aescariom/In3/circuits/In3Bluetooth_HC-05/bluetooth_board.png

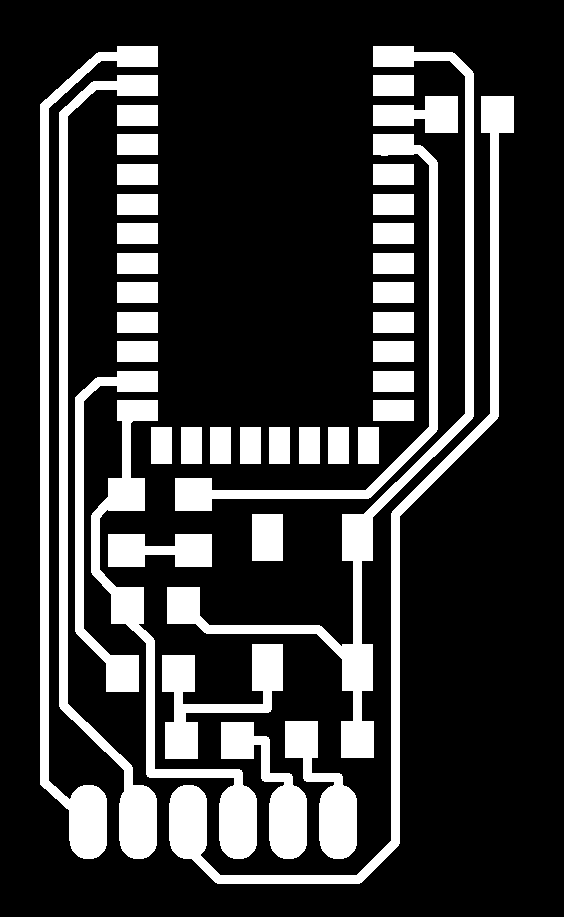
circuits/In3Bluetooth_HC-05/bluetooth_board.png
