aescariom/In3/circuits/In3Bluetooth_HC-05/bluetooth_cut.png

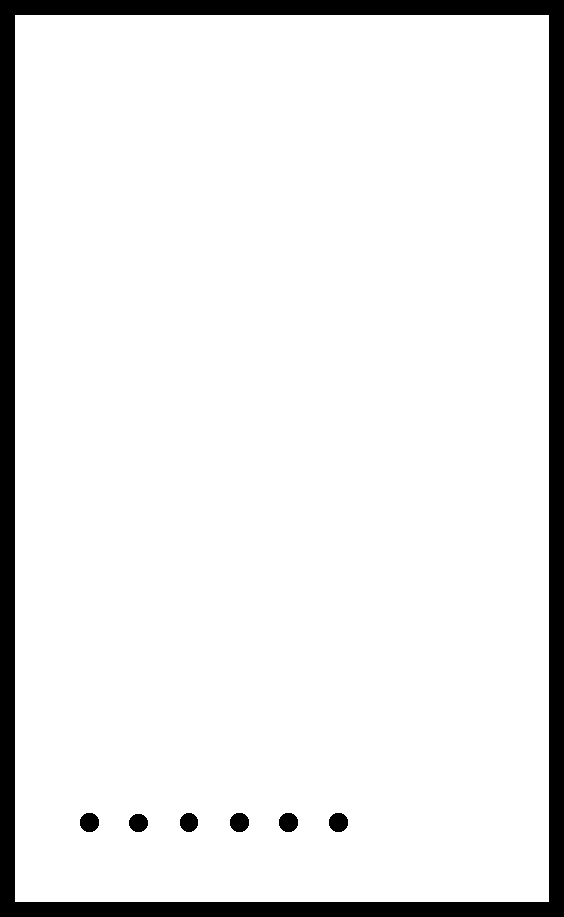
circuits/In3Bluetooth_HC-05/bluetooth_cut.png
