aescariom/In3/structure/3D printing/left_nozzle.stl

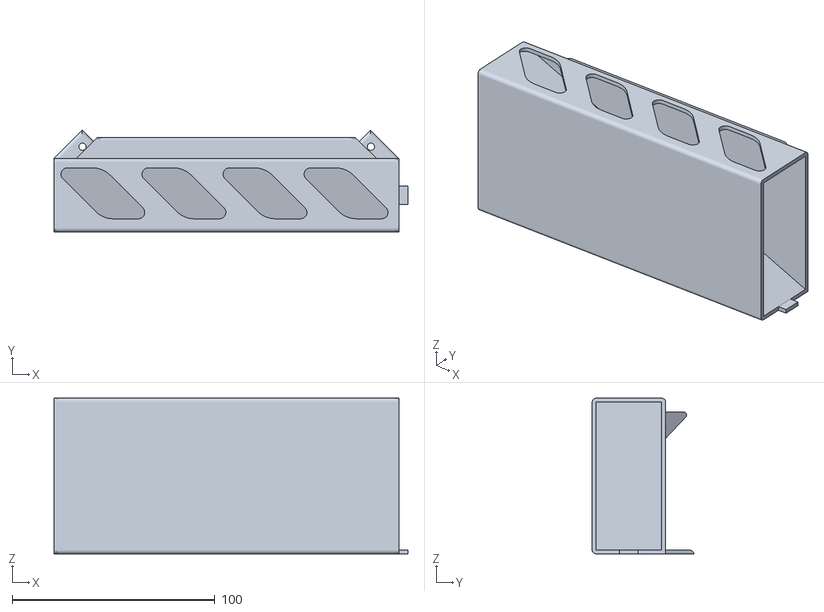
[picture p3: CAD file, 2015-09-20]
structure/3D printing/left_nozzle.stl
174.6 x 50.2 x 76.8
