aescariom/In3/structure/Cut/in3_base_30mm.dxf

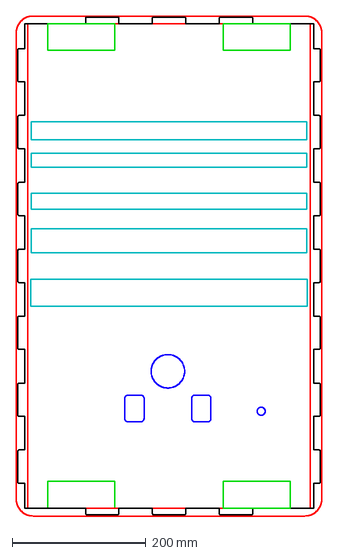
[picture p4: CAD file, 2015-09-20]
structure/Cut/in3_base_30mm.dxf
456.4 x 747.4 mm
