aescariom/In3/structure/Molding & Casting/axis/negative_mold.stl

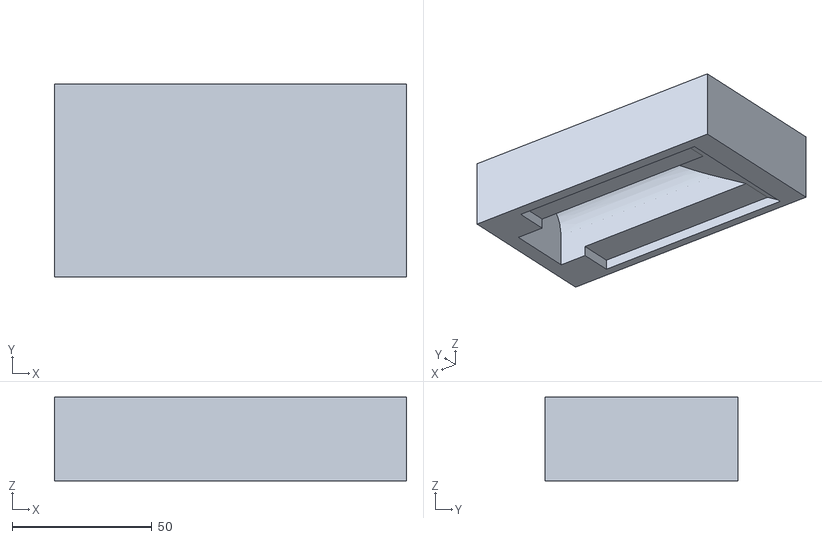
[picture p5: CAD file, 2015-09-20]
structure/Molding & Casting/axis/negative_mold.stl
126.0 x 69.0 x 30.0
