aescariom/In3/structure/3D printing/nozzle_splitter.stl

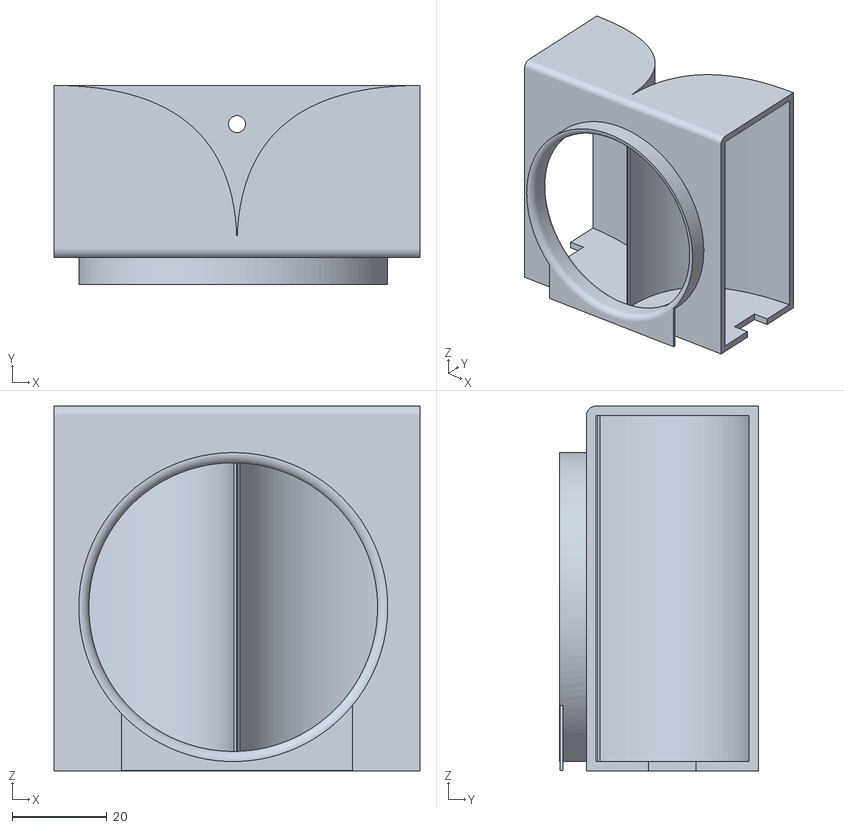
[picture p6: CAD file, 2015-09-20]
structure/3D printing/nozzle_splitter.stl
77.1 x 41.9 x 76.8
