aescariom/In3/structure/Cut/in3_legs_17.5mm.dxf

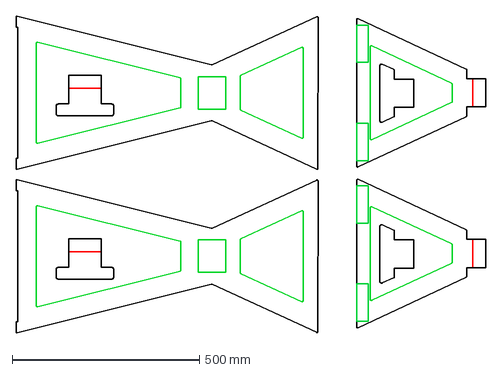
[picture p7: CAD file, 2015-09-20]
structure/Cut/in3_legs_17.5mm.dxf
1254.4 x 844.8 mm
