aescariom/In3/structure/Cut/in3_box_10mm.dxf

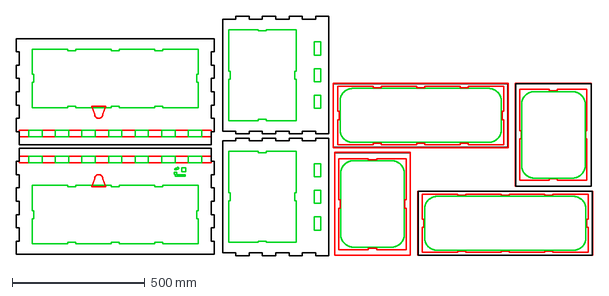
[picture p8: CAD file, 2015-09-20]
structure/Cut/in3_box_10mm.dxf
2168.4 x 899.7 mm
