aescariom/In3/structure/3D printing/tube.stl

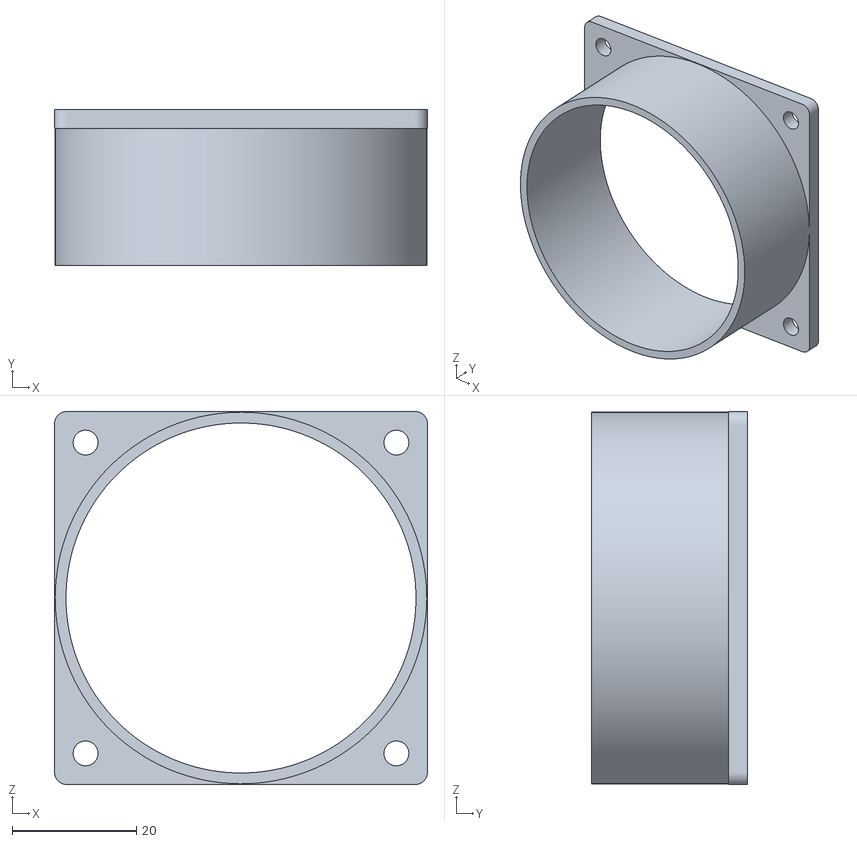
[picture p9: CAD file, 2015-09-20]
structure/3D printing/tube.stl
60.0 x 25.0 x 60.0
