aescariom/In3/structure/Cut/in3_bed_15mm.dxf

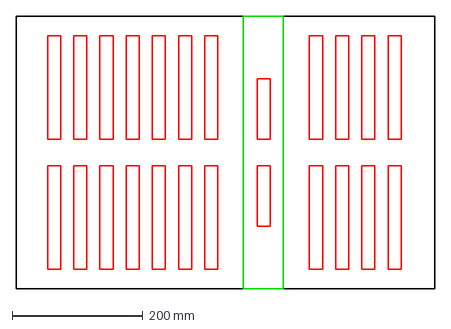
[picture p10: CAD file, 2015-09-20]
structure/Cut/in3_bed_15mm.dxf
638.6 x 416.0 mm
