aescariom/In3/structure/3D printing/corner.stl

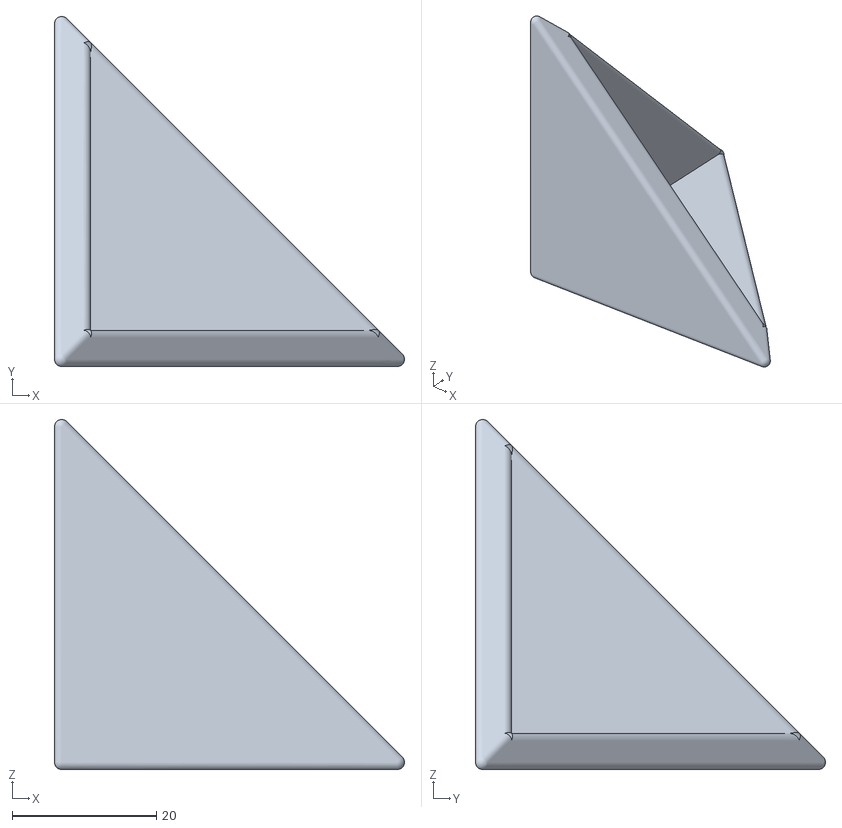
[picture p11: CAD file, 2015-07-16]
structure/3D printing/corner.stl
48.6 x 48.6 x 48.6
