aescariom/In3/structure/3D printing/inner_ring.stl

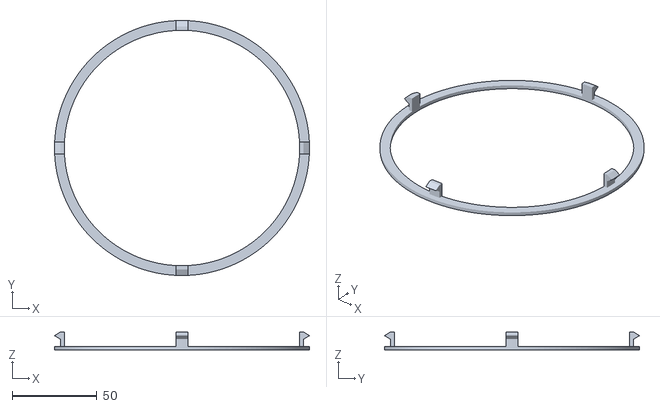
[picture p12: CAD file, 2015-07-16]
structure/3D printing/inner_ring.stl
150.8 x 150.8 x 10.6
