aescariom/In3/structure/3D printing/outter_ring.stl

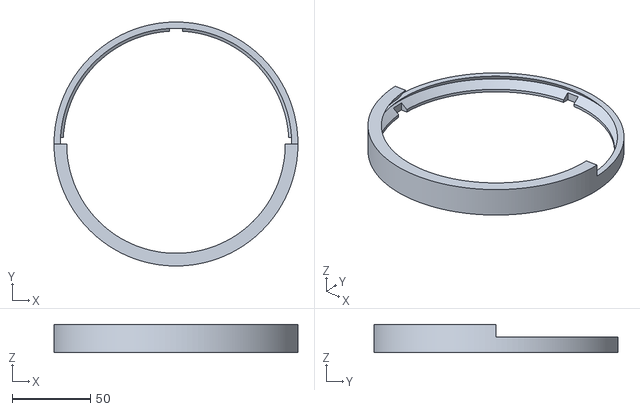
[picture p13: CAD file, 2015-07-16]
structure/3D printing/outter_ring.stl
155.5 x 155.5 x 17.9
