aescariom/In3/(list of files, cad)

Other CAD files:
structure/3D printing/right_nozzle.stl
