aescariom/In3/docs/structure_assembling/Assembling.tex

\documentclass{article}
\usepackage[a4paper,margin=1in,landscape]{geometry}
\usepackage{blindtext}
\usepackage{tikz}
\usetikzlibrary{calc}
\begin{document}
\begin{center}
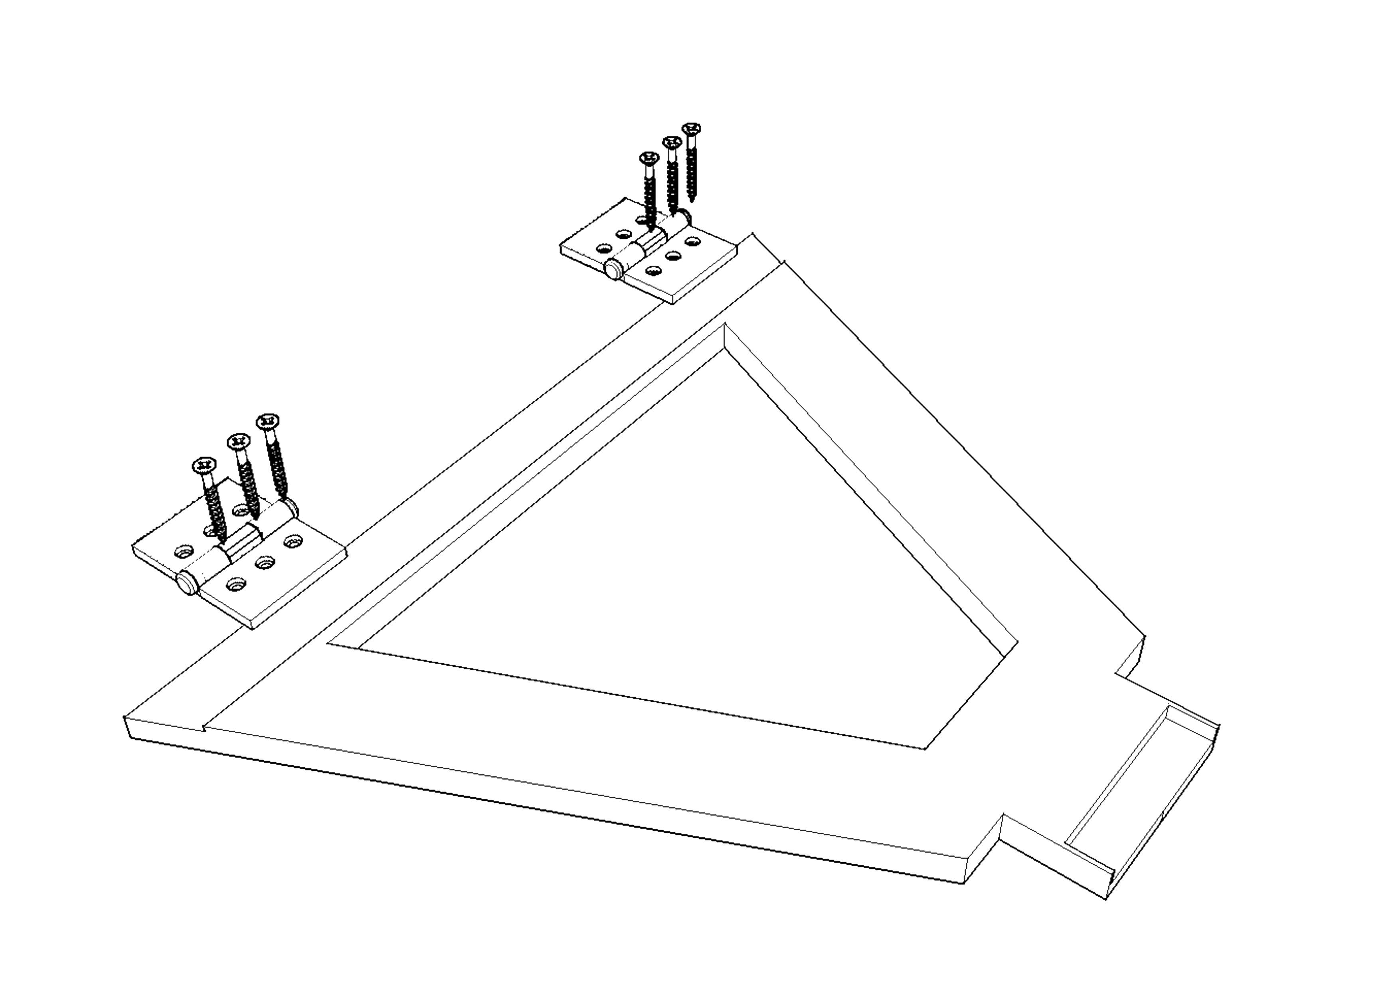
[picture p14: docs/structure_assembling/assembling/step1.png]
	
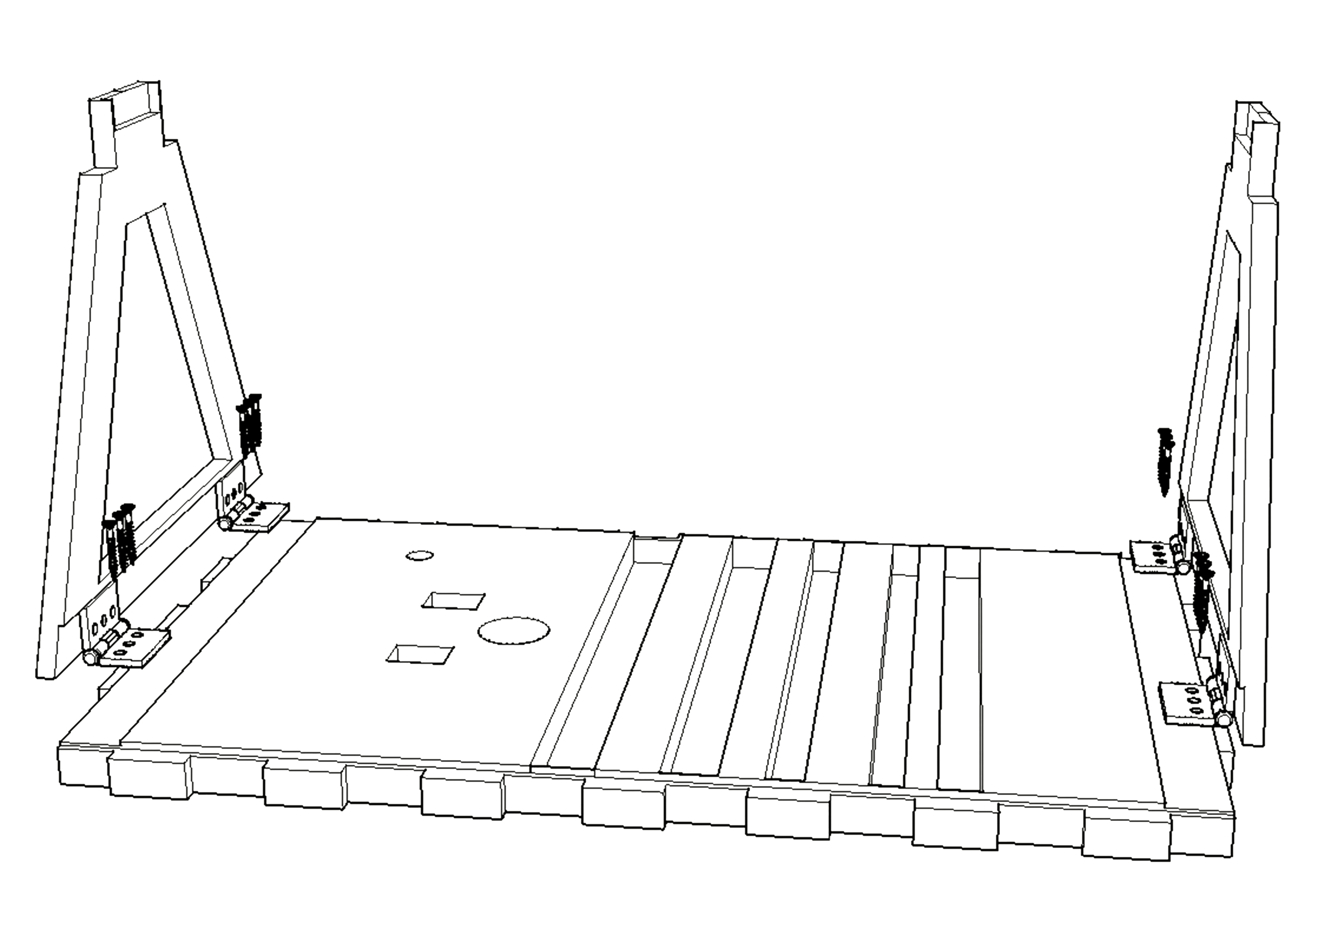
[picture p15: docs/structure_assembling/assembling/step2.png]
	
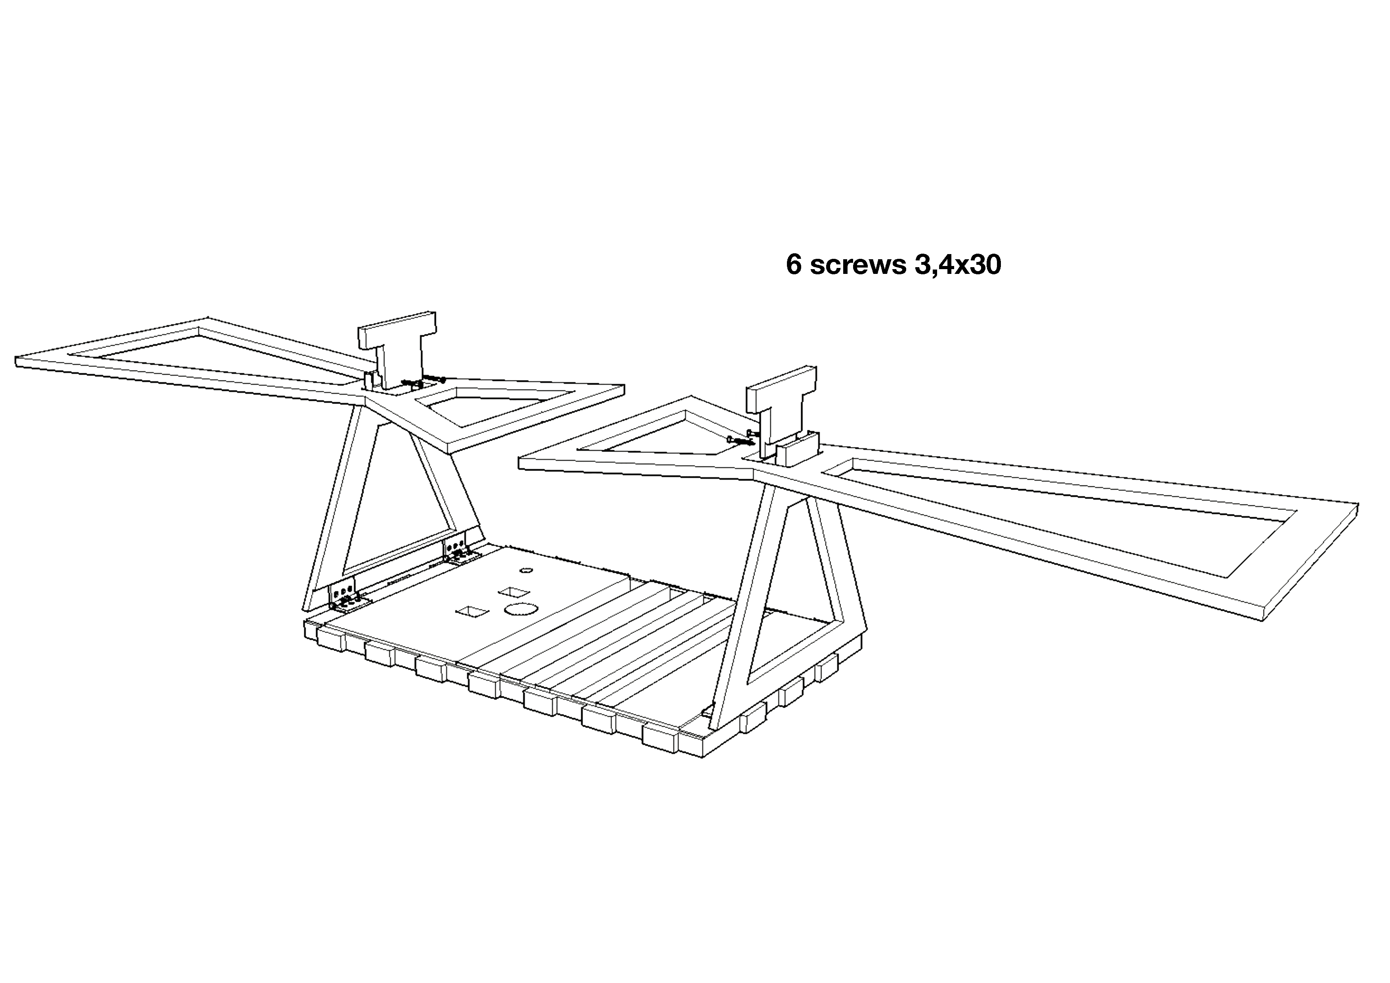
[picture p16: docs/structure_assembling/assembling/step3.png]
	
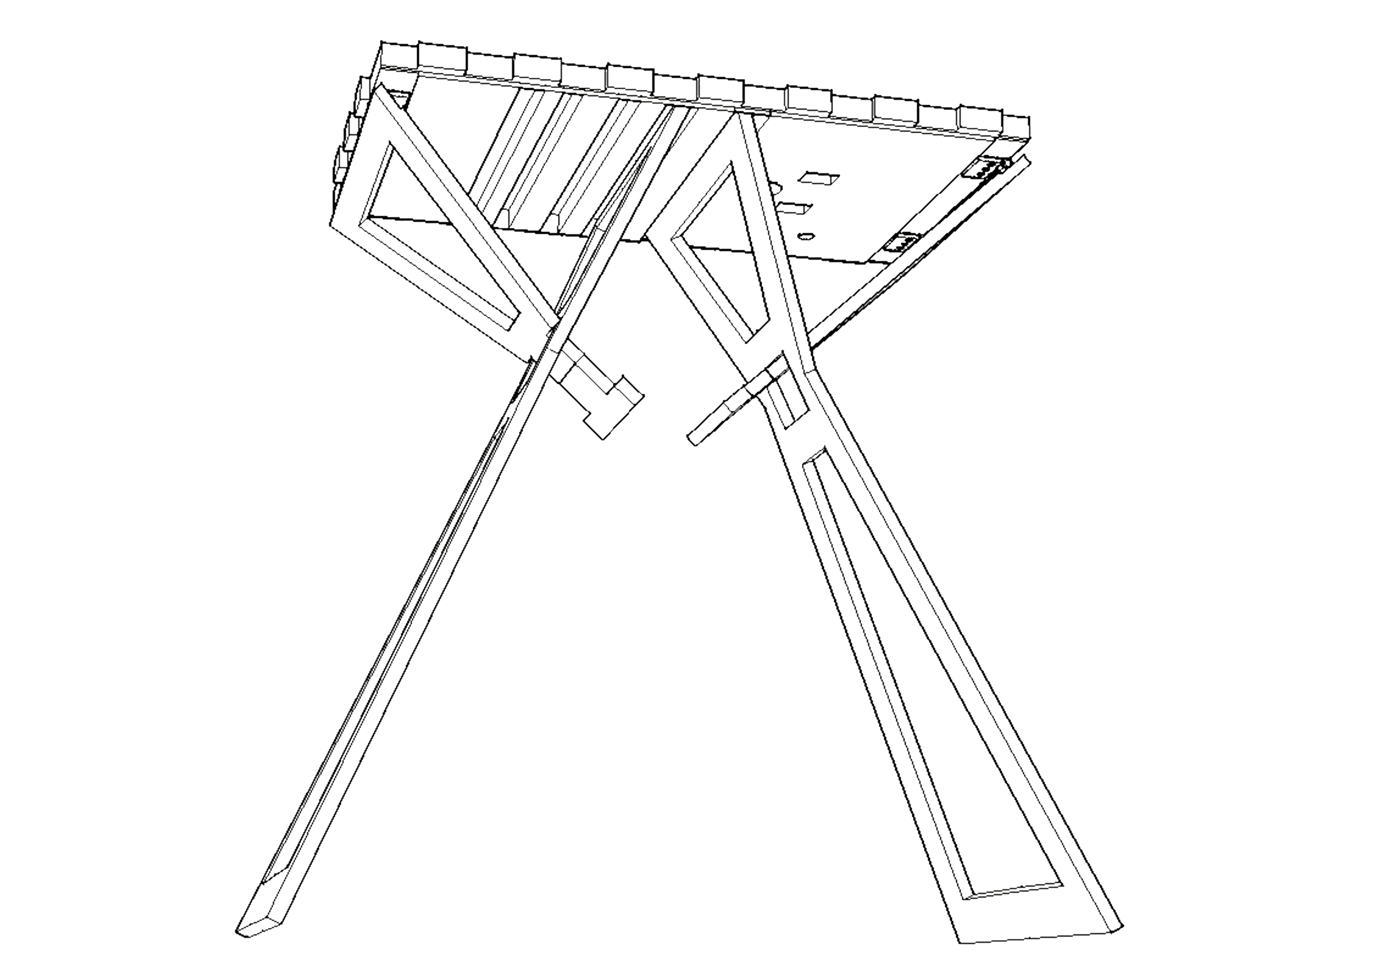
[picture p17: docs/structure_assembling/assembling/step4.png]
	
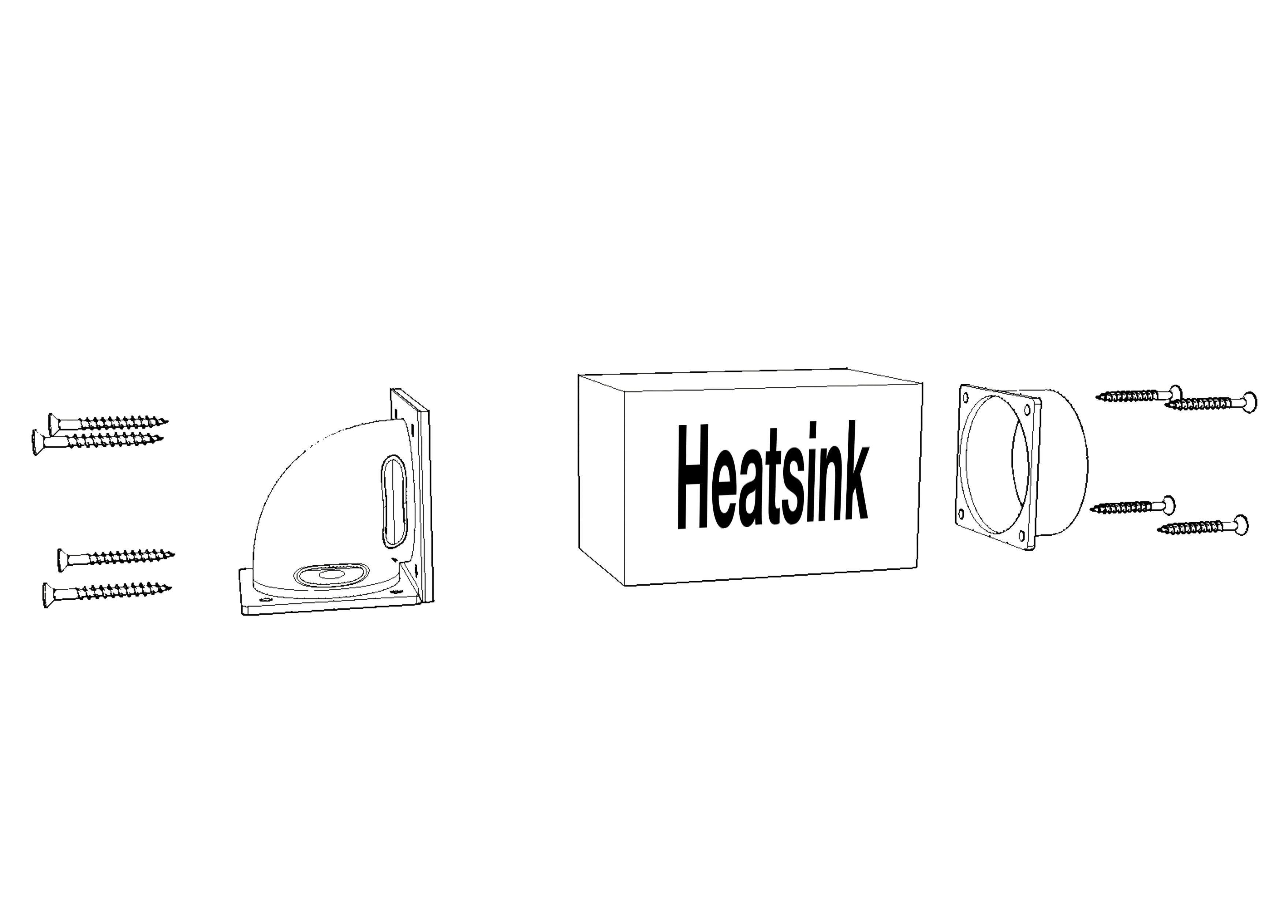
[picture p18: docs/structure_assembling/assembling/step5.png]
	
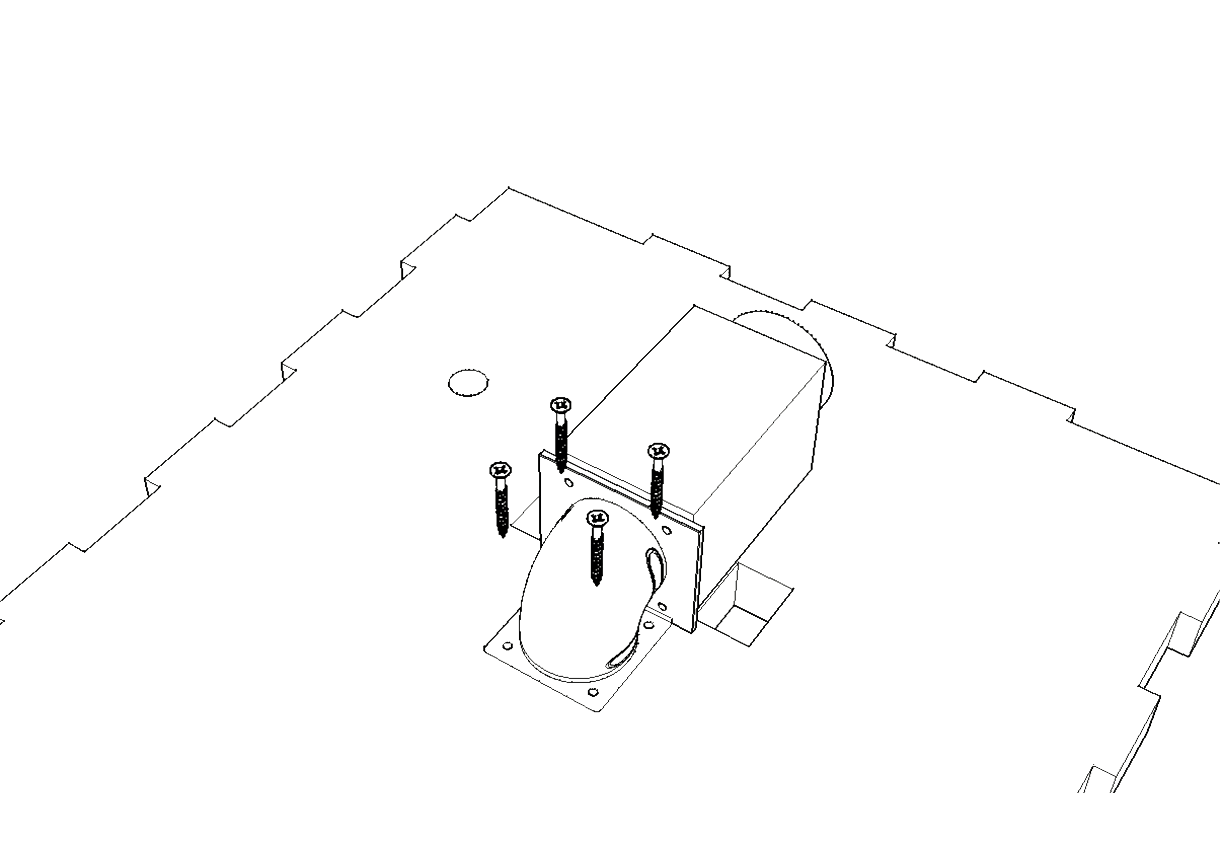
[picture p19: docs/structure_assembling/assembling/step6.png]
	
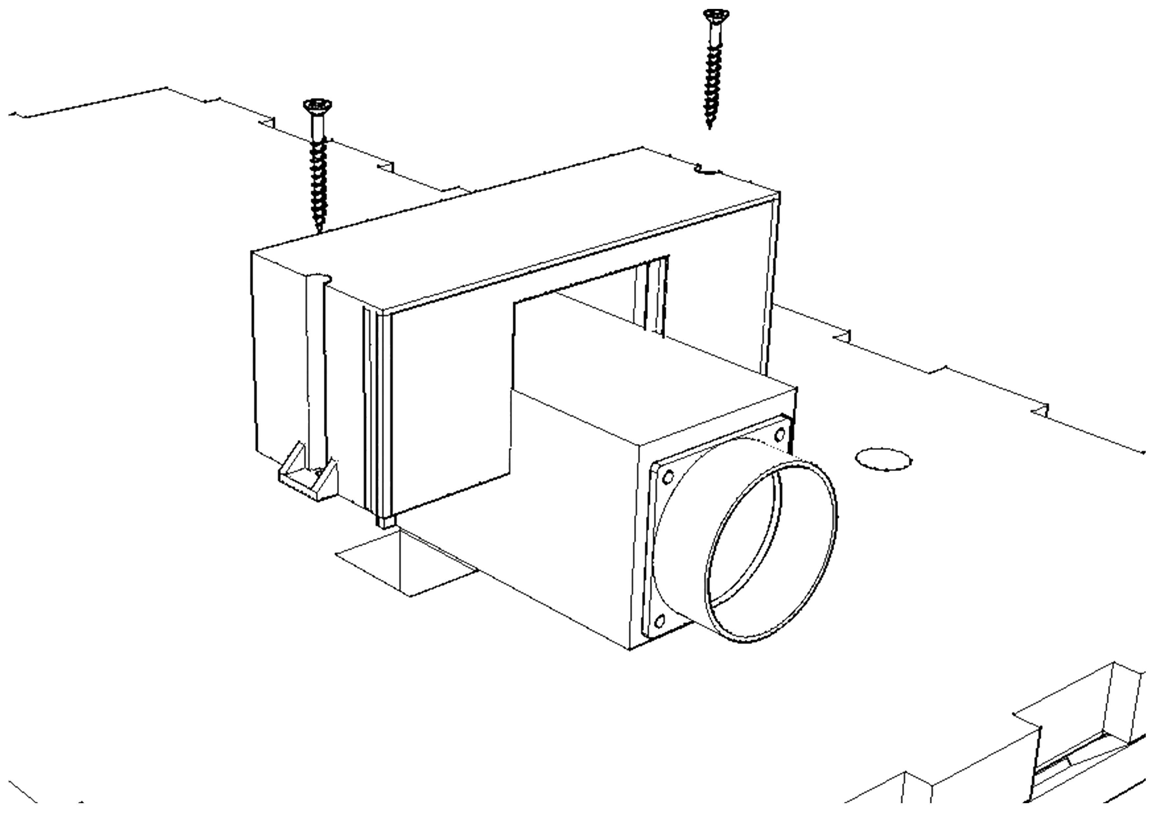
[picture p20: docs/structure_assembling/assembling/step7.png]
	
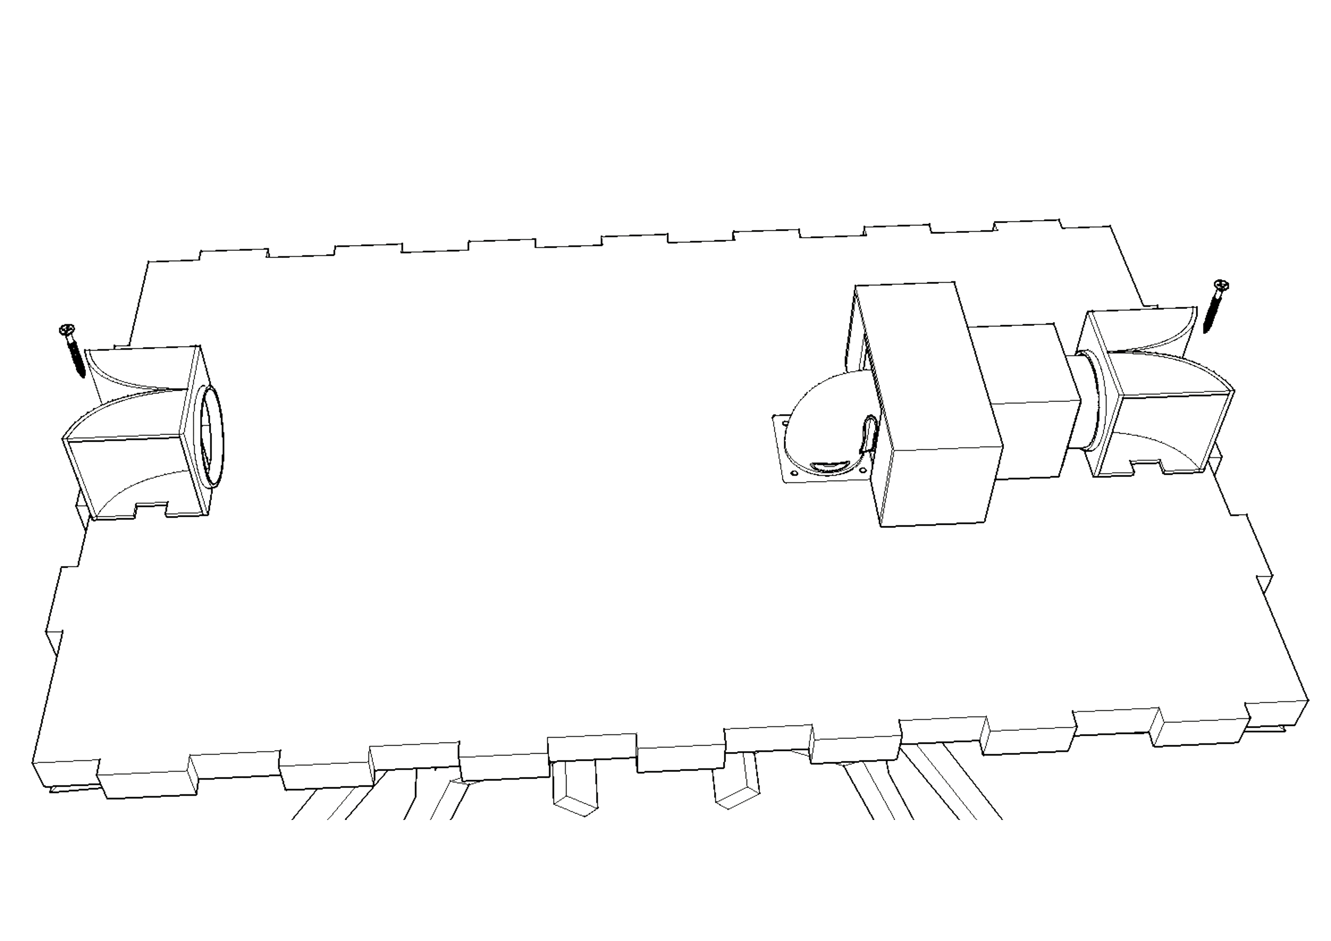
[picture p21: docs/structure_assembling/assembling/step8.png]
	
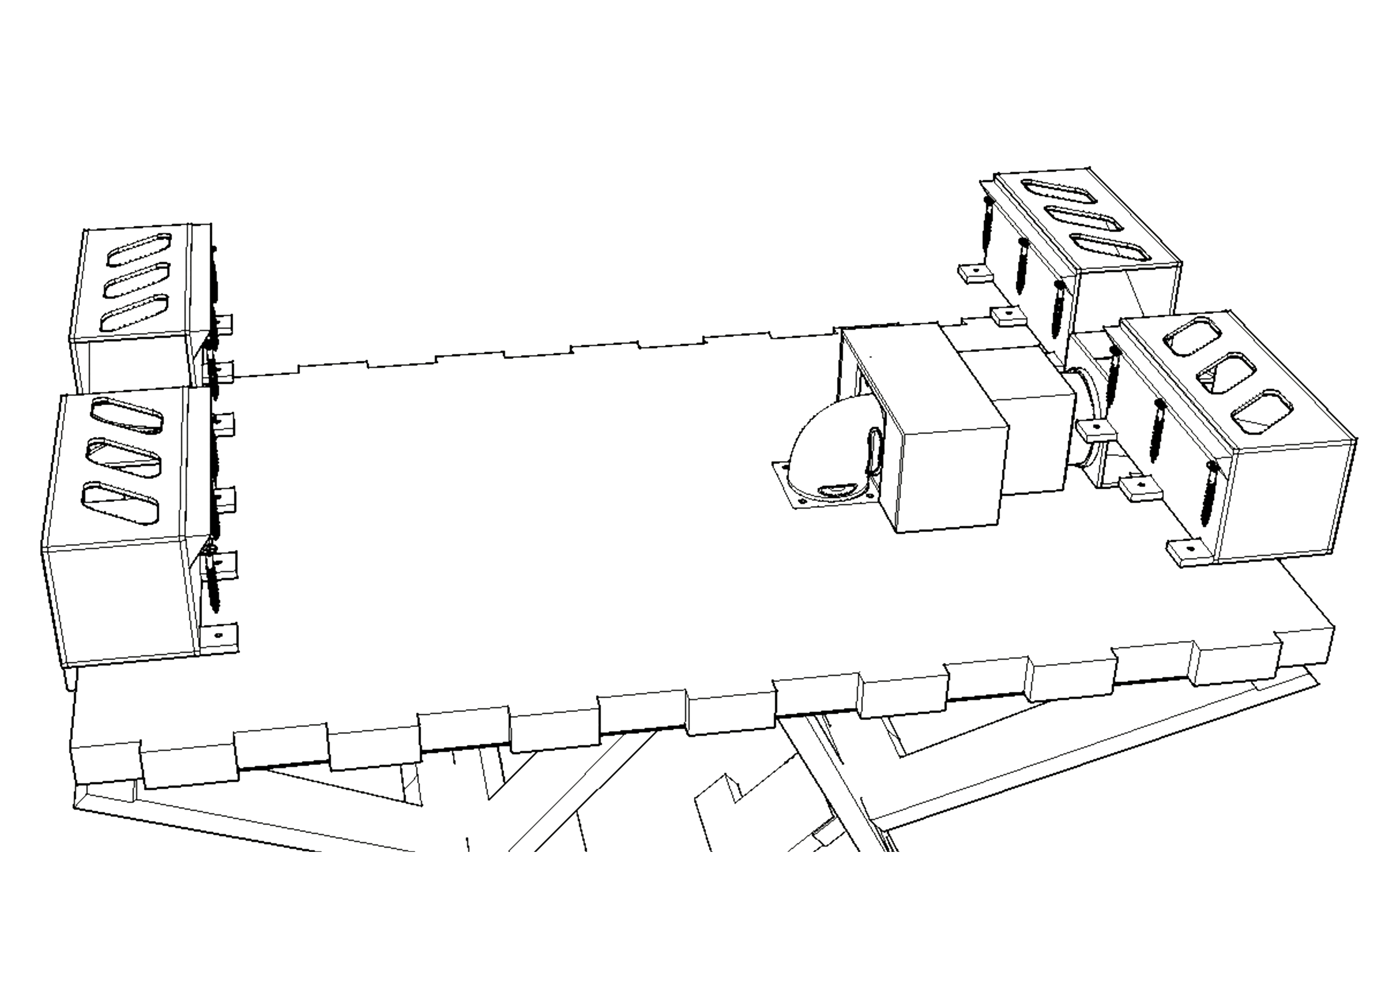
[picture p22: docs/structure_assembling/assembling/step9.png]
	
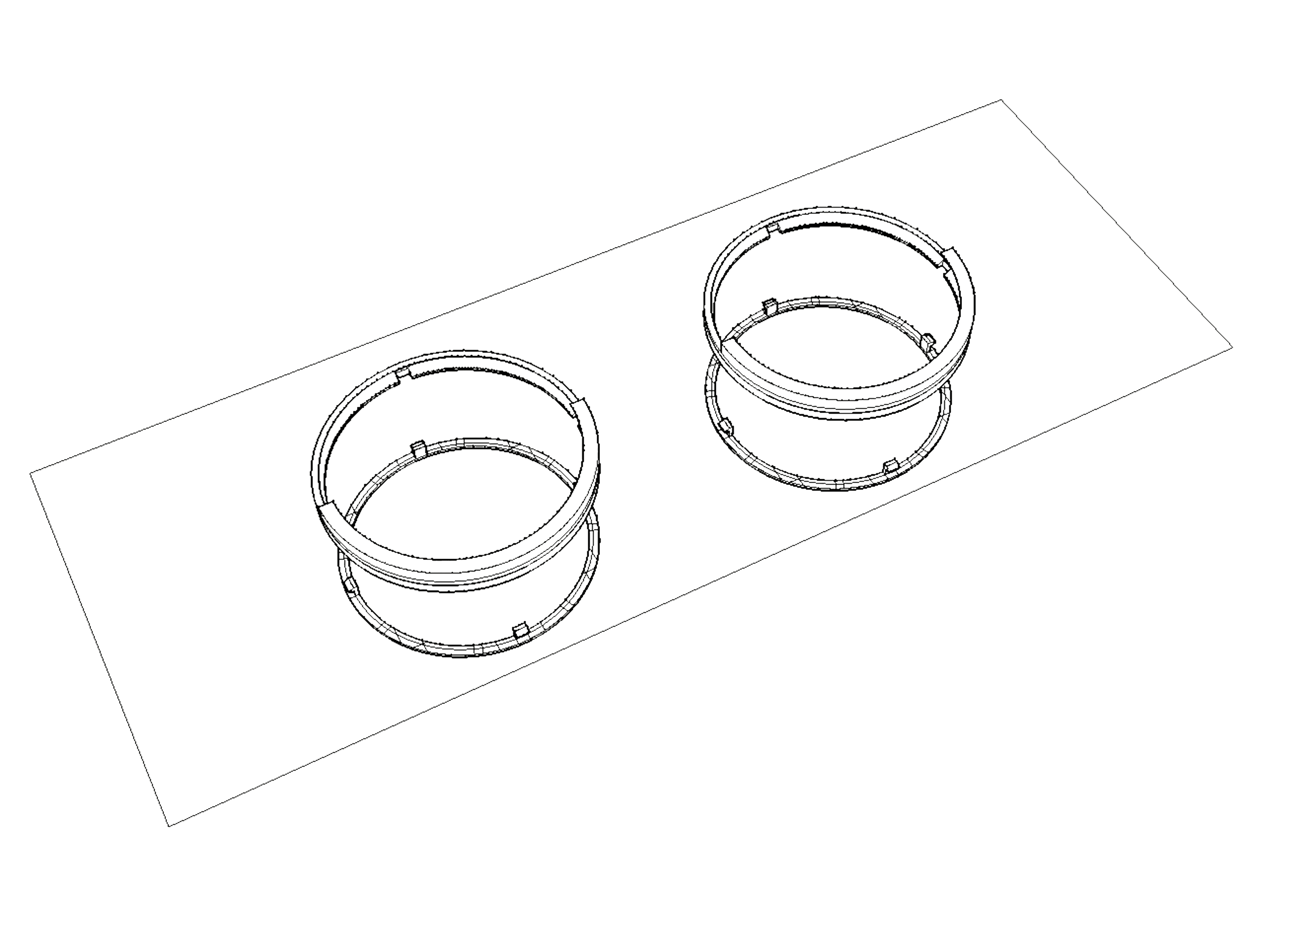
[picture p23: docs/structure_assembling/assembling/step10.png]
	
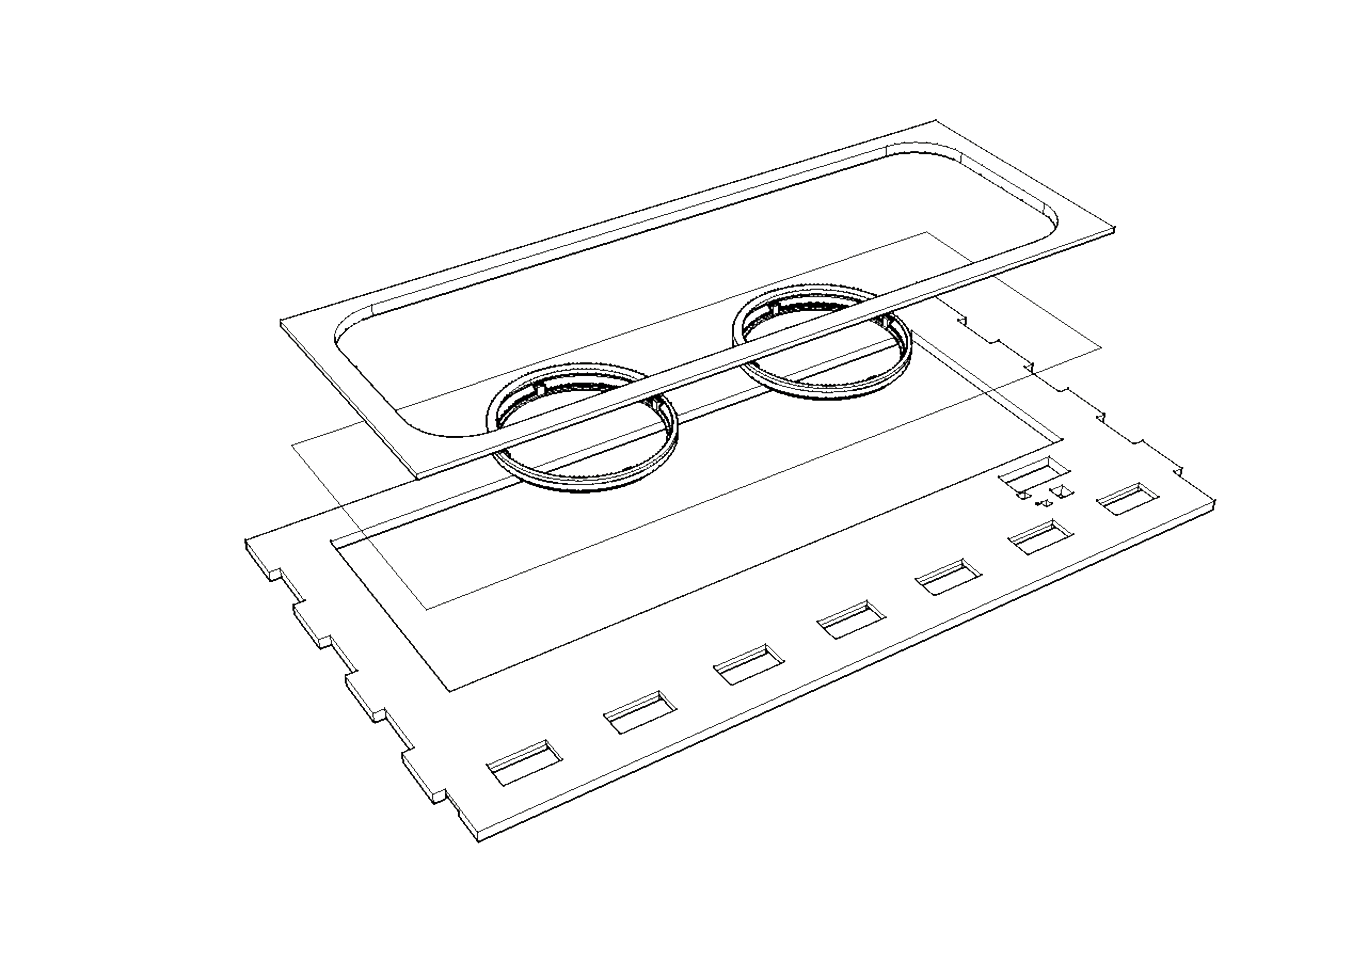
[picture p24: docs/structure_assembling/assembling/step11.png]
	
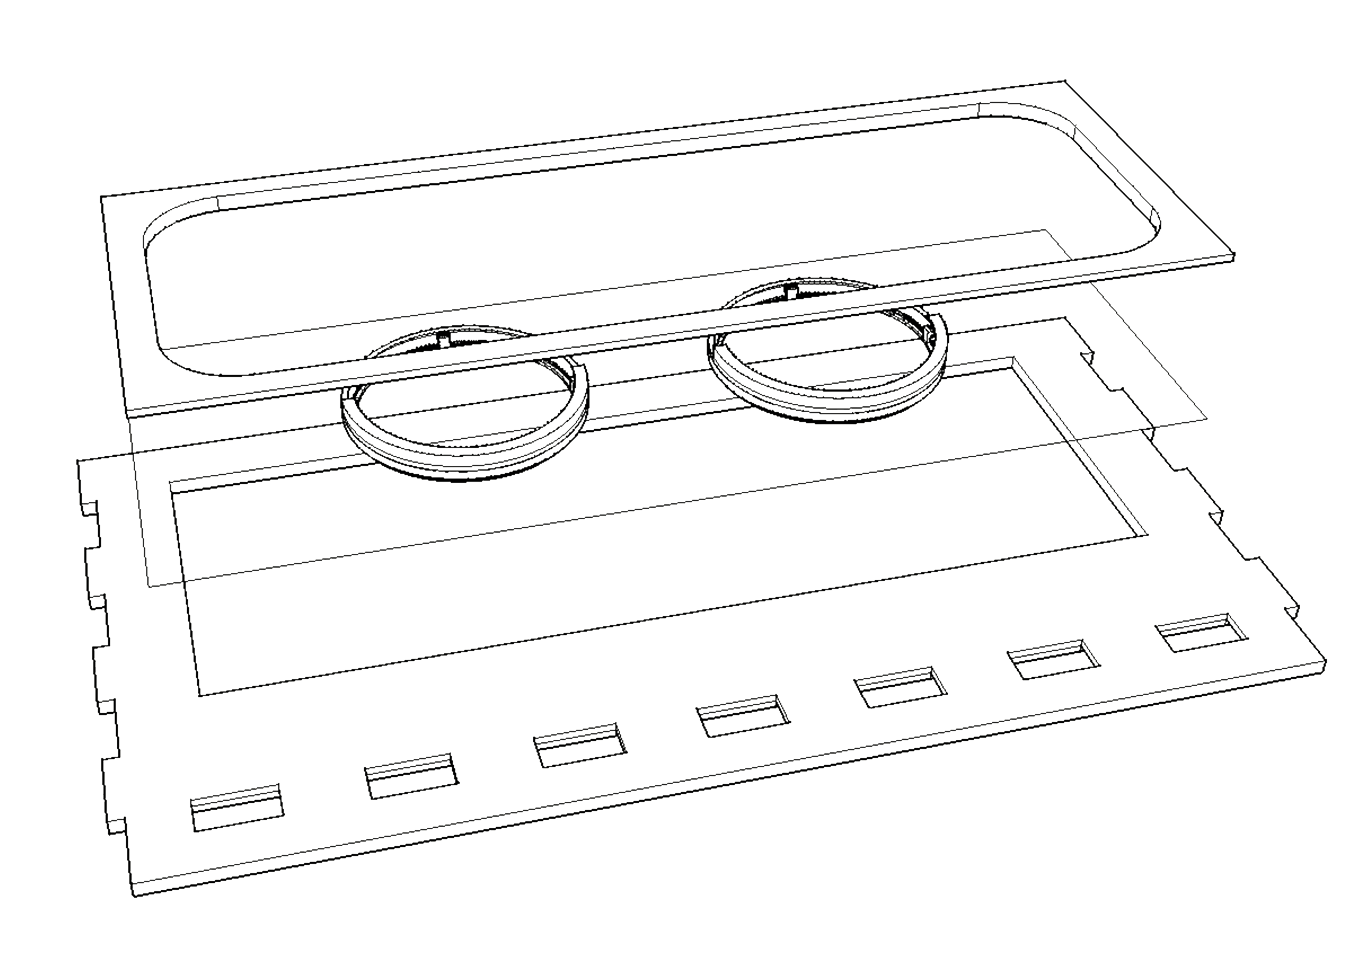
[picture p25: docs/structure_assembling/assembling/step11_2.png]
	
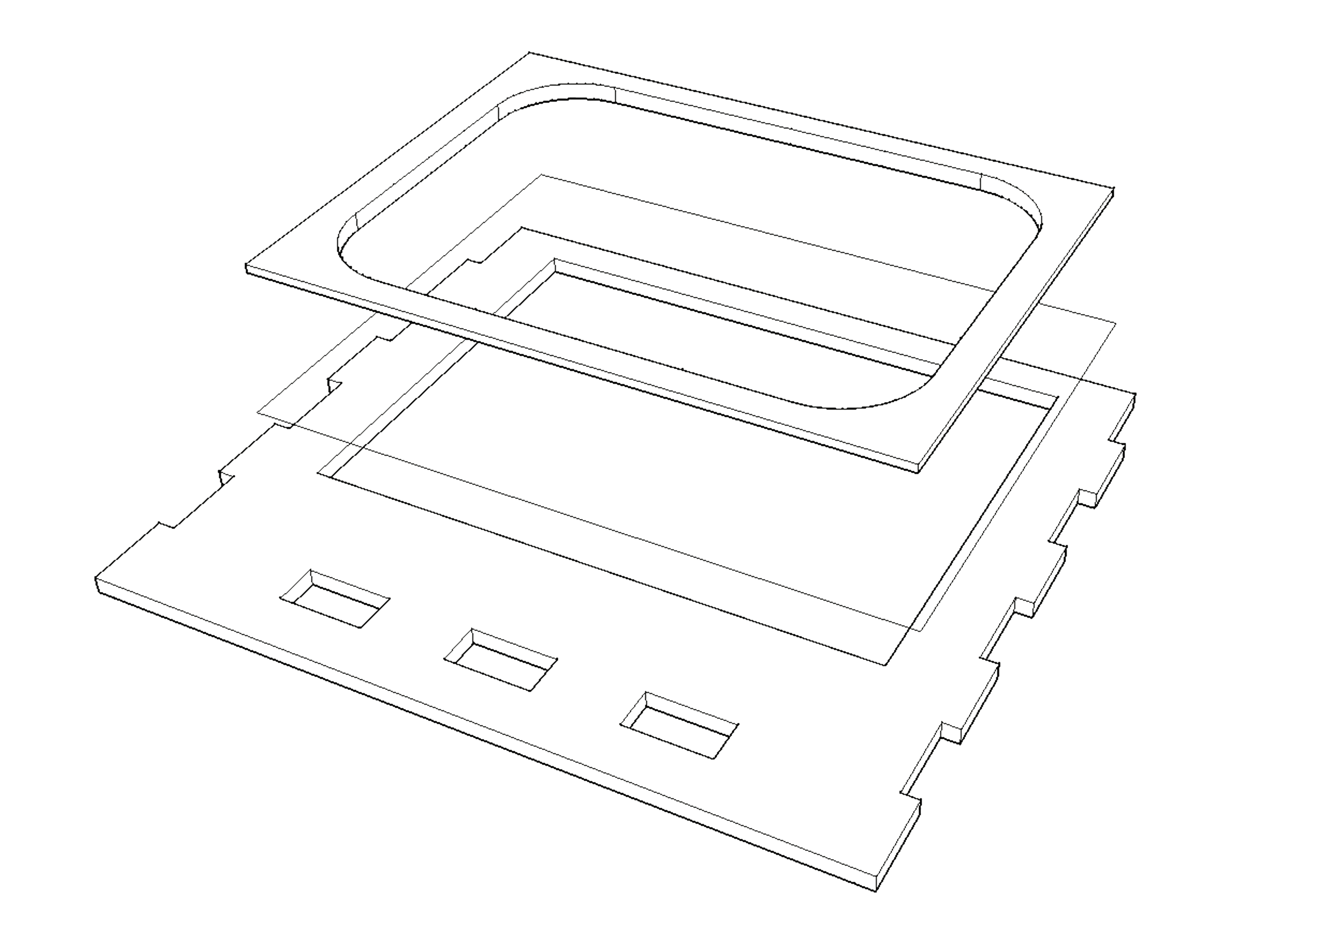
[picture p26: docs/structure_assembling/assembling/step12.png]
	
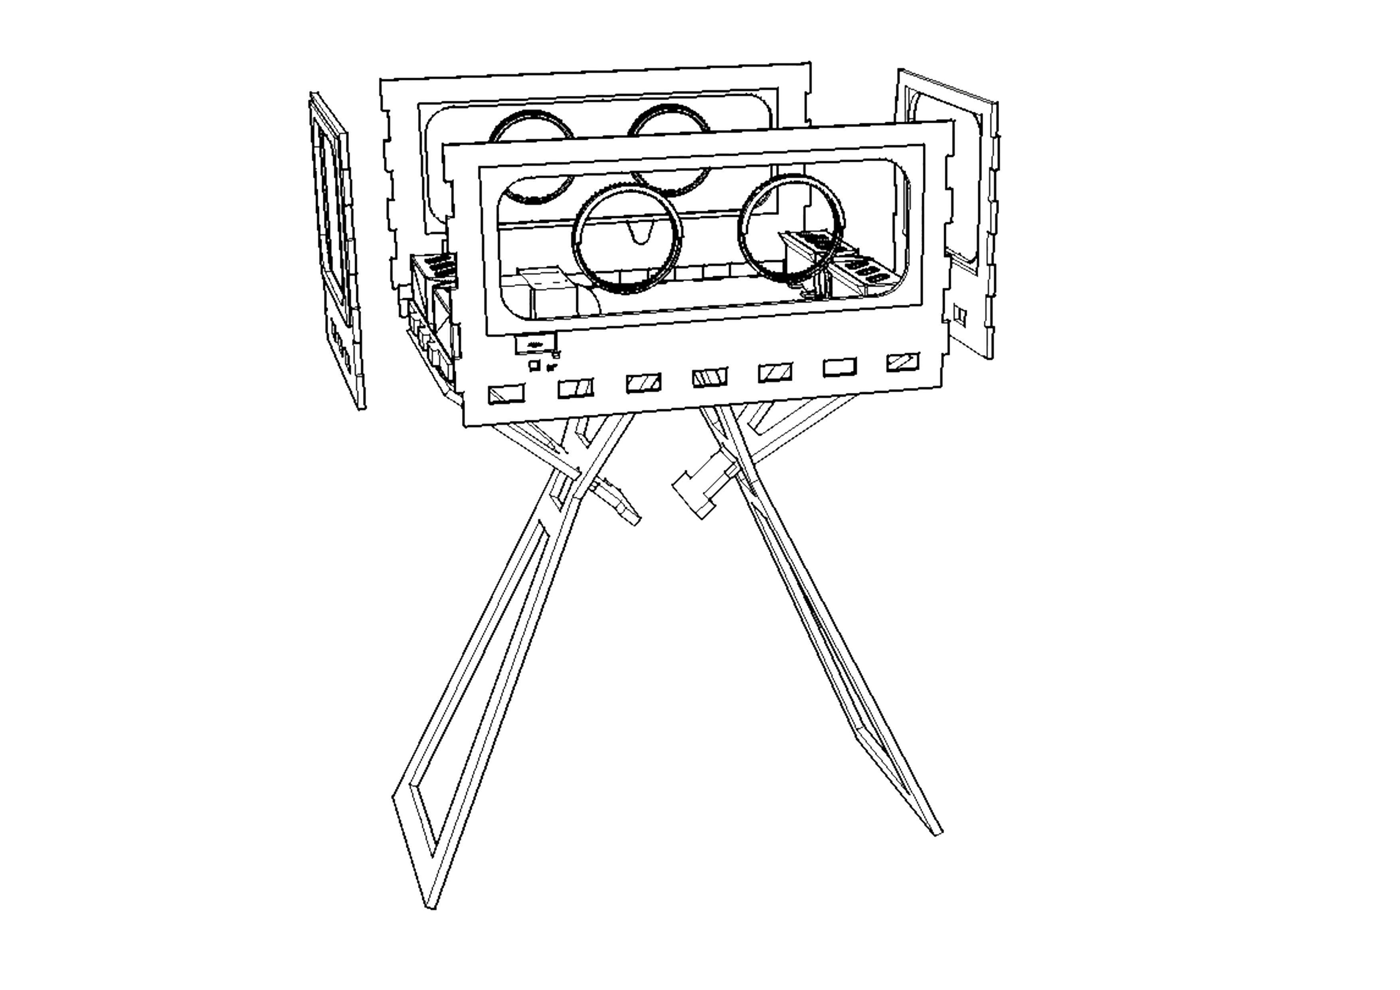
[picture p27: docs/structure_assembling/assembling/step13.png]
	
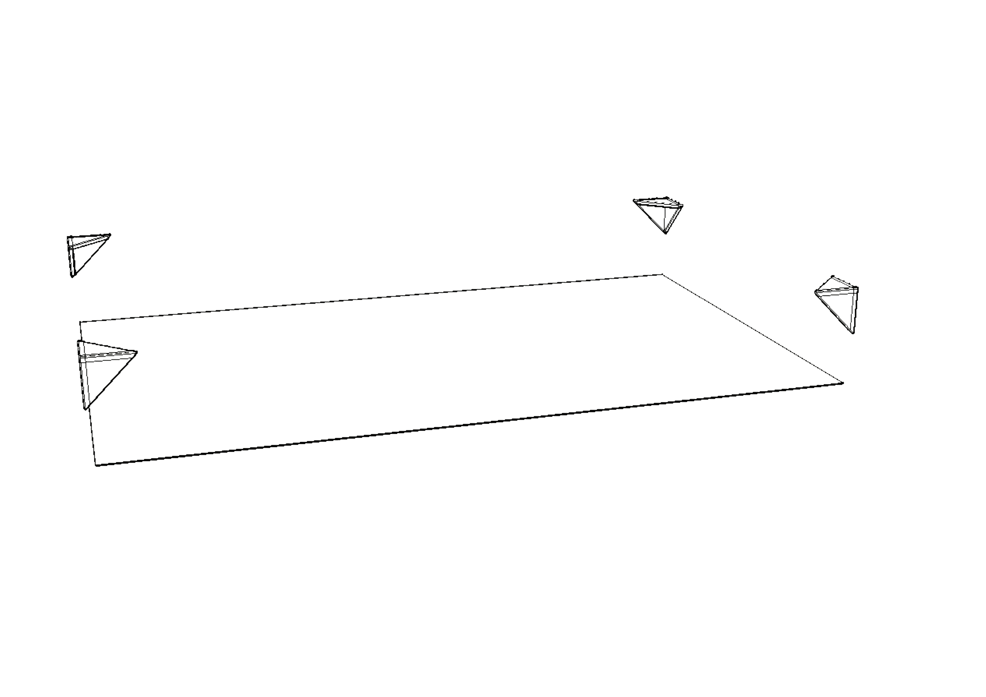
[picture p28: docs/structure_assembling/assembling/step14.png]
	
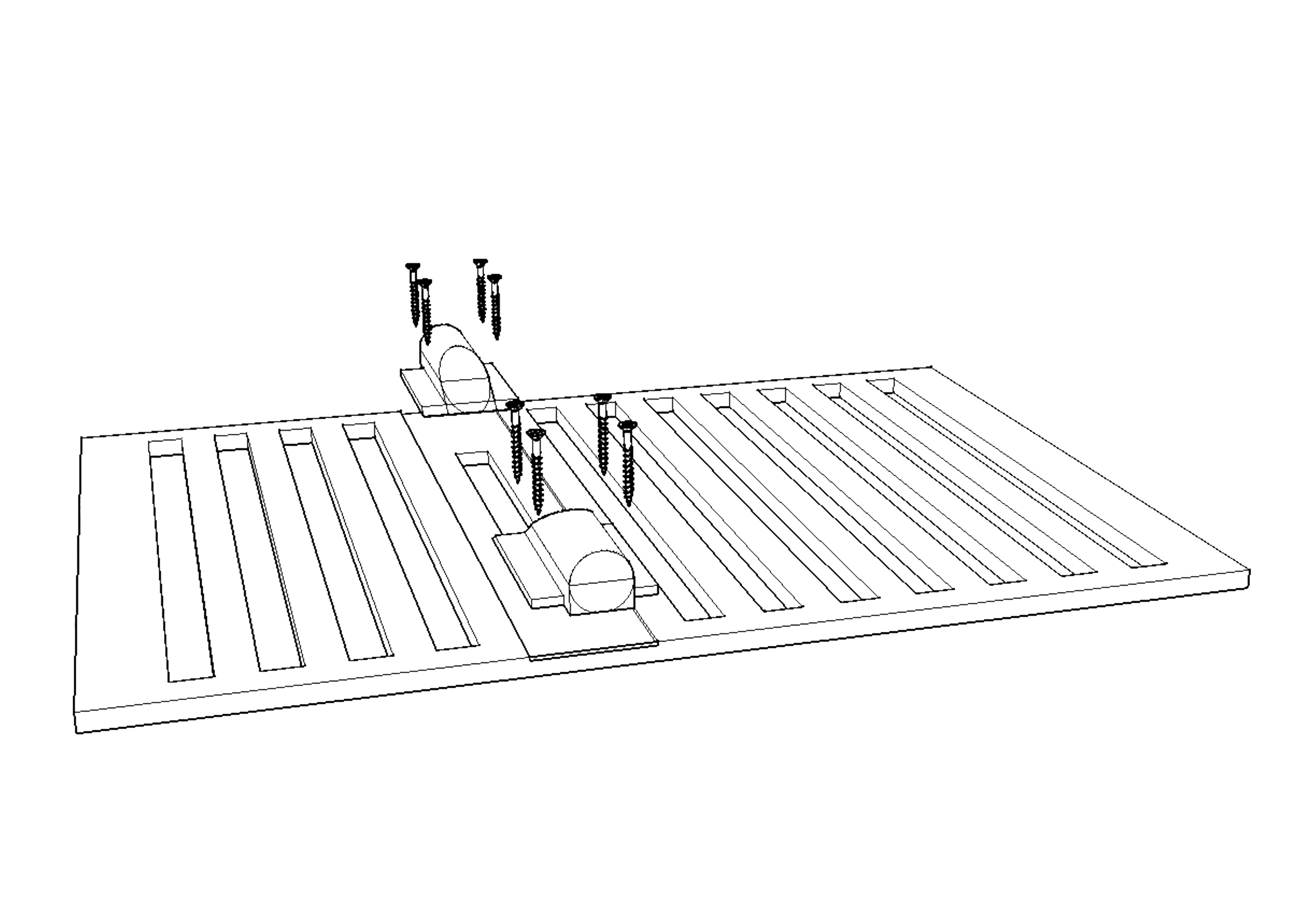
[picture p29: docs/structure_assembling/assembling/step15.png]
	
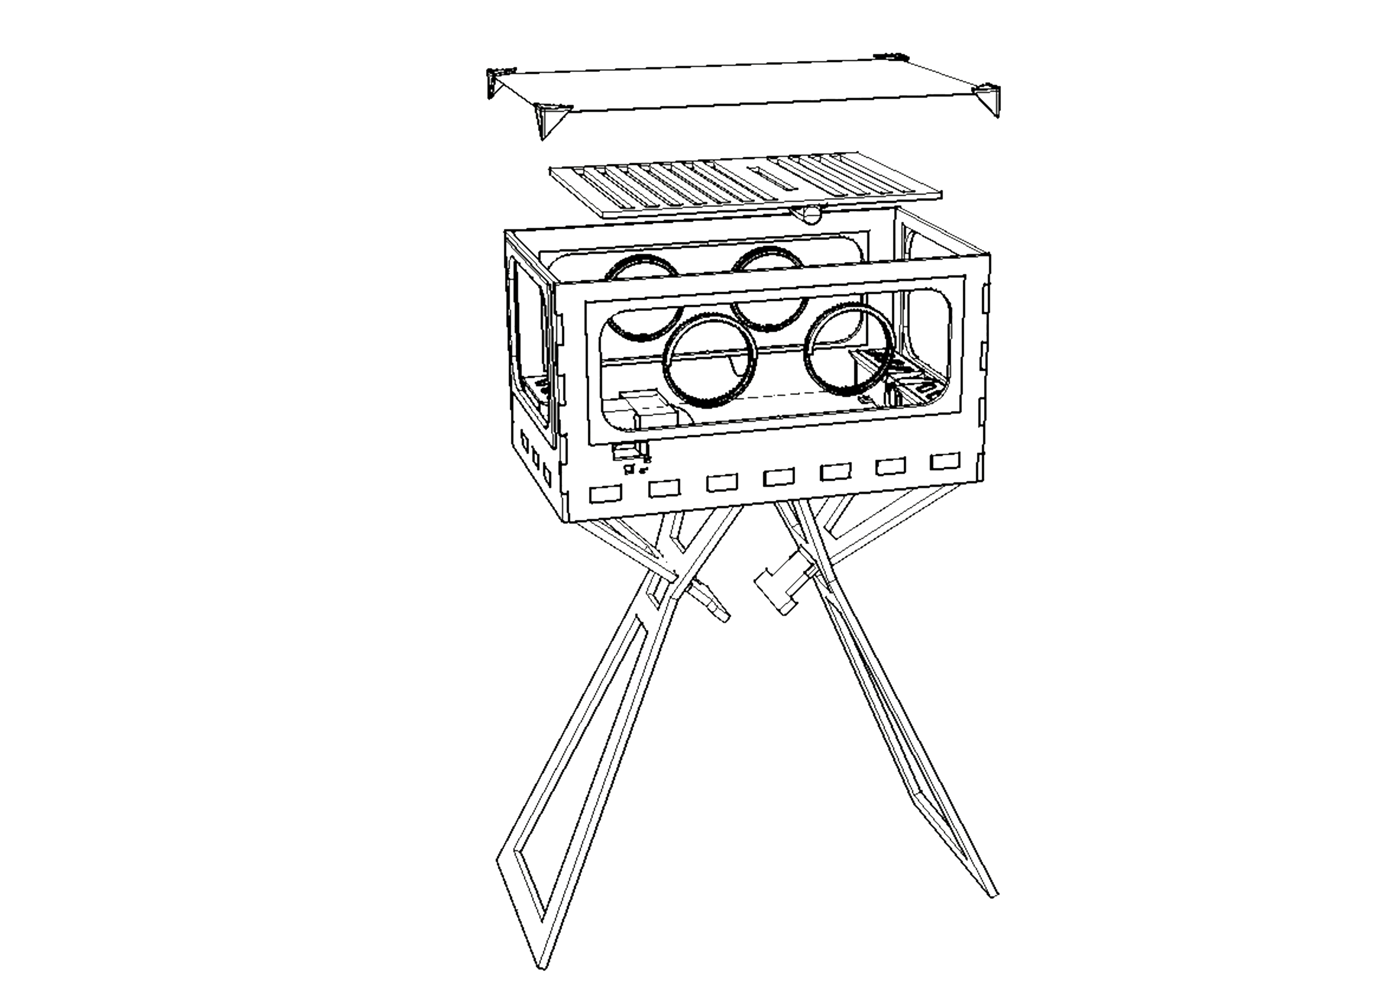
[picture p30: docs/structure_assembling/assembling/step16.png]
	
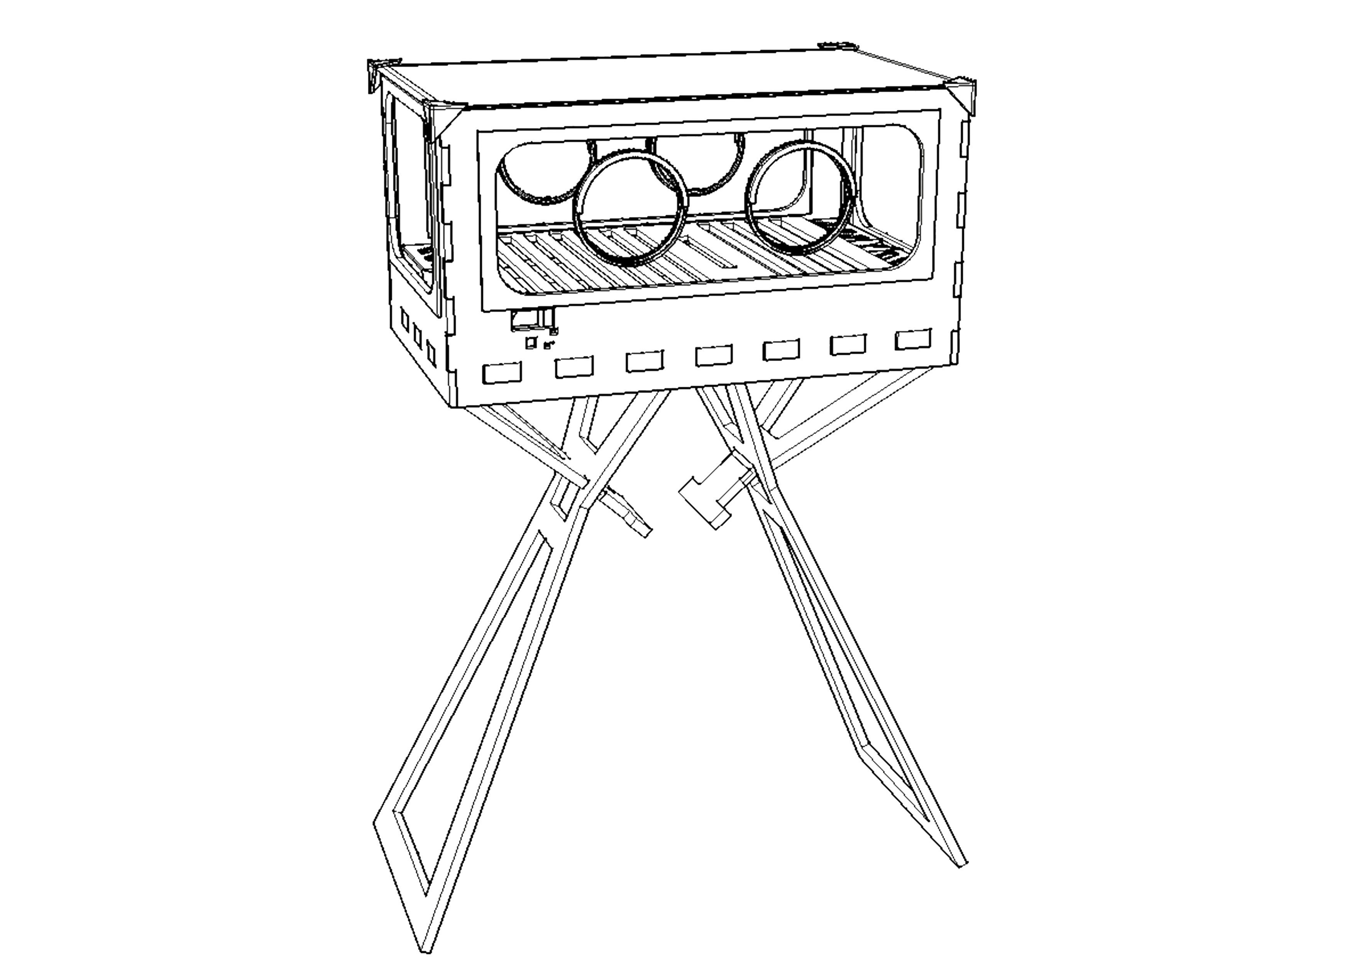
[picture p31: docs/structure_assembling/assembling/result.png]
	
\end{center}
\end{document}
