aescariom/In3/circuits/In3ControlPanel/in3controlpanel.brd

## EAGLE design circuits/In3ControlPanel/in3controlpanel.brd (2017-02-27)

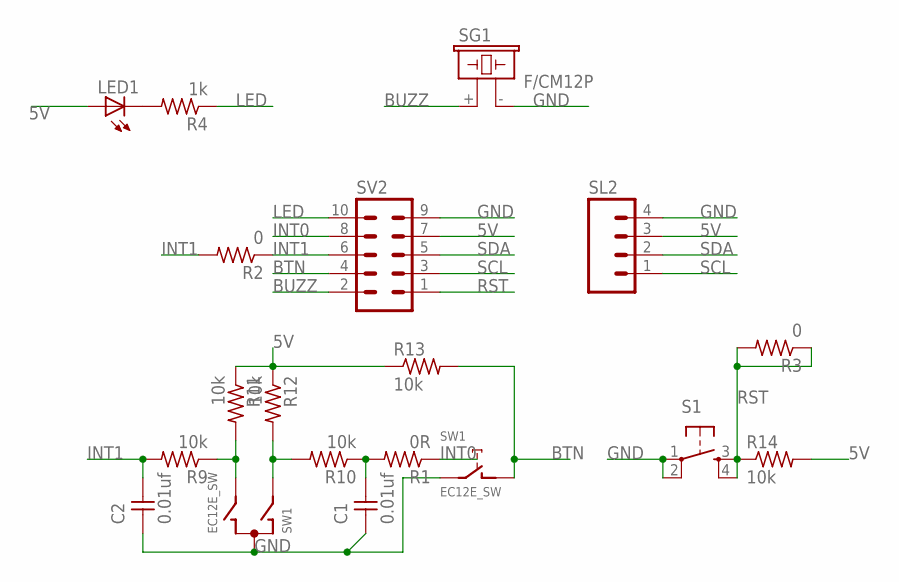
[picture p38: schematic in3controlpanel.sch]

Parts:
C1, C2: 0.01uf; 1206
LED1: LED_E; LED_1206
R1: 0R; 1206
R2, R3: 0; 1206
R4: 1k; 1206
R9, R10, R11, R12, R13, R14: 10k; 1206
S1: 6MM_SWITCH6MM_SWITCH; 6MM_SWITCH
SG1: F/CM12P
SL2: MA04; 04PA
SV2: MA05-2
SW1: EC12E_SW; ALPS_EC12E_SW

Connections:
5V: LED1.A, R11.1, R12.1, R13.1, R14.2, SL2.3, SV2.7
BTN: R13.2, SV2.4, SW1.D (1)
BUZZ: SG1.+ (1), SV2.2
GND: C1.1, C2.1, S1.1, S1.2 (P1), SG1.- (2), SL2.4, SV2.9, SW1.C, SW1.E (2)
INT0: C1.2, R1.1, R1.2, R10.1, SV2.8
INT1: C2.2, R2.1, R2.2, R9.2, SV2.6
LED: R4.1, SV2.10
unnamed: LED1.C, R4.2
unnamed: R9.1, R11.2, SW1.B
unnamed: R10.2, R12.2, SW1.A
RST: R3.1, R3.2, R14.1, S1.3 (S), S1.4 (S1), SV2.1
SCL: SL2.1, SV2.3
SDA: SL2.2, SV2.5

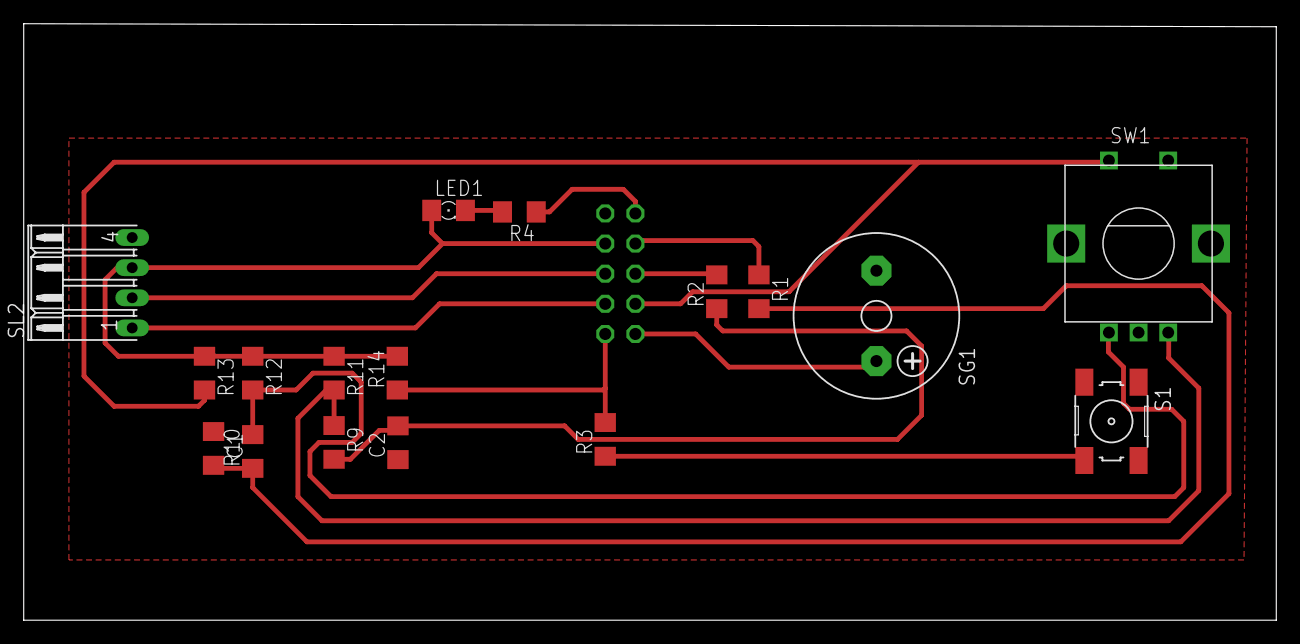
[picture p39: board in3controlpanel.brd from above]

Board: 2 copper layers, 105.6 x 50.3 mm, 18 parts (1 on the bottom side), 13 nets.
