aescariom/In3/circuits/In3Temperature/in3temperature.brd

## EAGLE design circuits/In3Temperature/in3temperature.brd (2017-02-27)

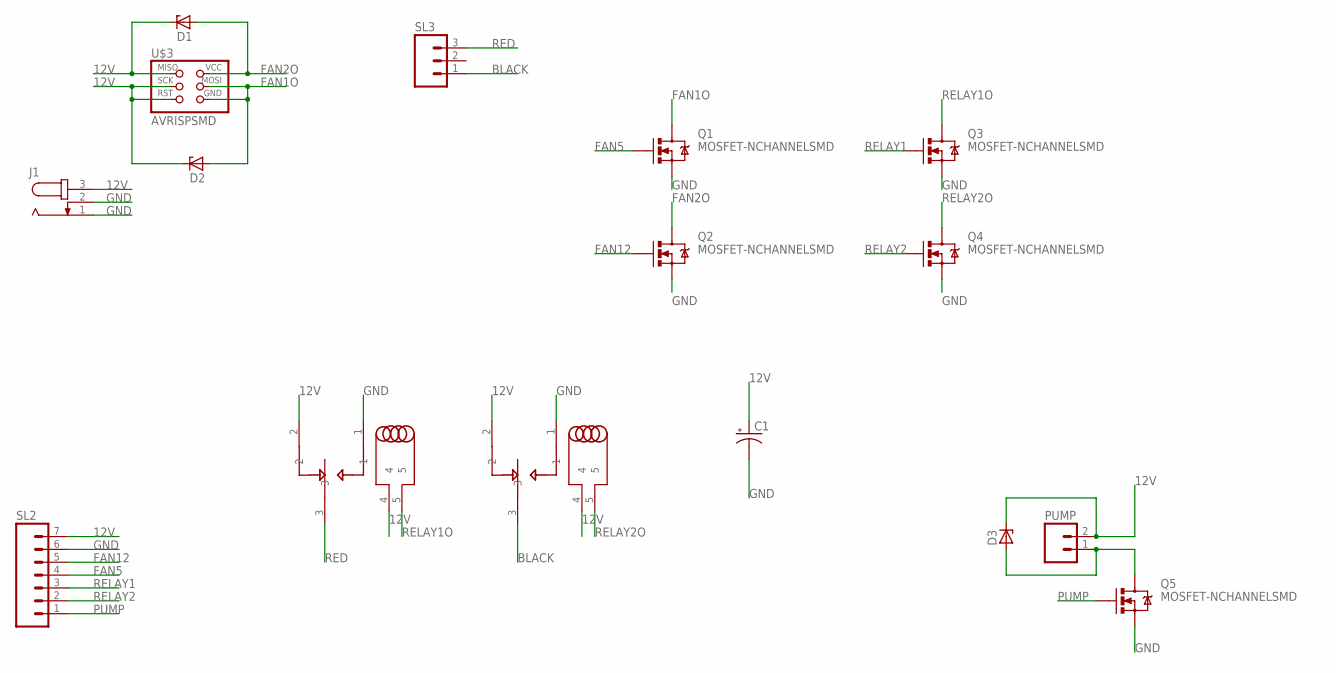
[picture p40: schematic in3temperature.sch]

Parts:
C1: CPOL-USE2.5-5; E2,5-5
D1, D2, D3: ZENER_DIODESOD123; SOD123
J1: JACK-PLUG1; SPC4078
PUMP: MA02; 02PA
Q1, Q2, Q3, Q4, Q5: MOSFET-NCHANNELSMD; SOT23-3
SL2: MA07; 07PA
SL3: MA03; 03P
U$1, U$2: RELAY-V23092THROUGH_HOLE; RELAY-V23092
U$3: AVRISPSMD; 2X03SMD

Connections:
12V: C1.+, D1.CATHODE, D2.CATHODE, D3.CATHODE, J1.3, PUMP.2, SL2.7, U$1.2, U$1.4, U$2.2, U$2.4, U$3.1 (MISO), U$3.3 (SCK), U$3.5 (RST)
BLACK: SL3.1, U$2.3
FAN1O: D2.ANODE, Q1.3 (D), U$3.4 (MOSI), U$3.6 (GND)
FAN2O: D1.ANODE, Q2.3 (D), U$3.2 (VCC)
FAN5: Q1.1 (G), SL2.4
FAN12: Q2.1 (G), SL2.5
GND: C1.-, J1.1, J1.2, Q1.2 (S), Q2.2 (S), Q3.2 (S), Q4.2 (S), Q5.2 (S), SL2.6, U$1.1, U$2.1
unnamed: D3.ANODE, PUMP.1, Q5.3 (D)
PUMP: Q5.1 (G), SL2.1
RED: SL3.3, U$1.3
RELAY1: Q3.1 (G), SL2.3
RELAY1O: Q3.3 (D), U$1.5
RELAY2: Q4.1 (G), SL2.2
RELAY2O: Q4.3 (D), U$2.5

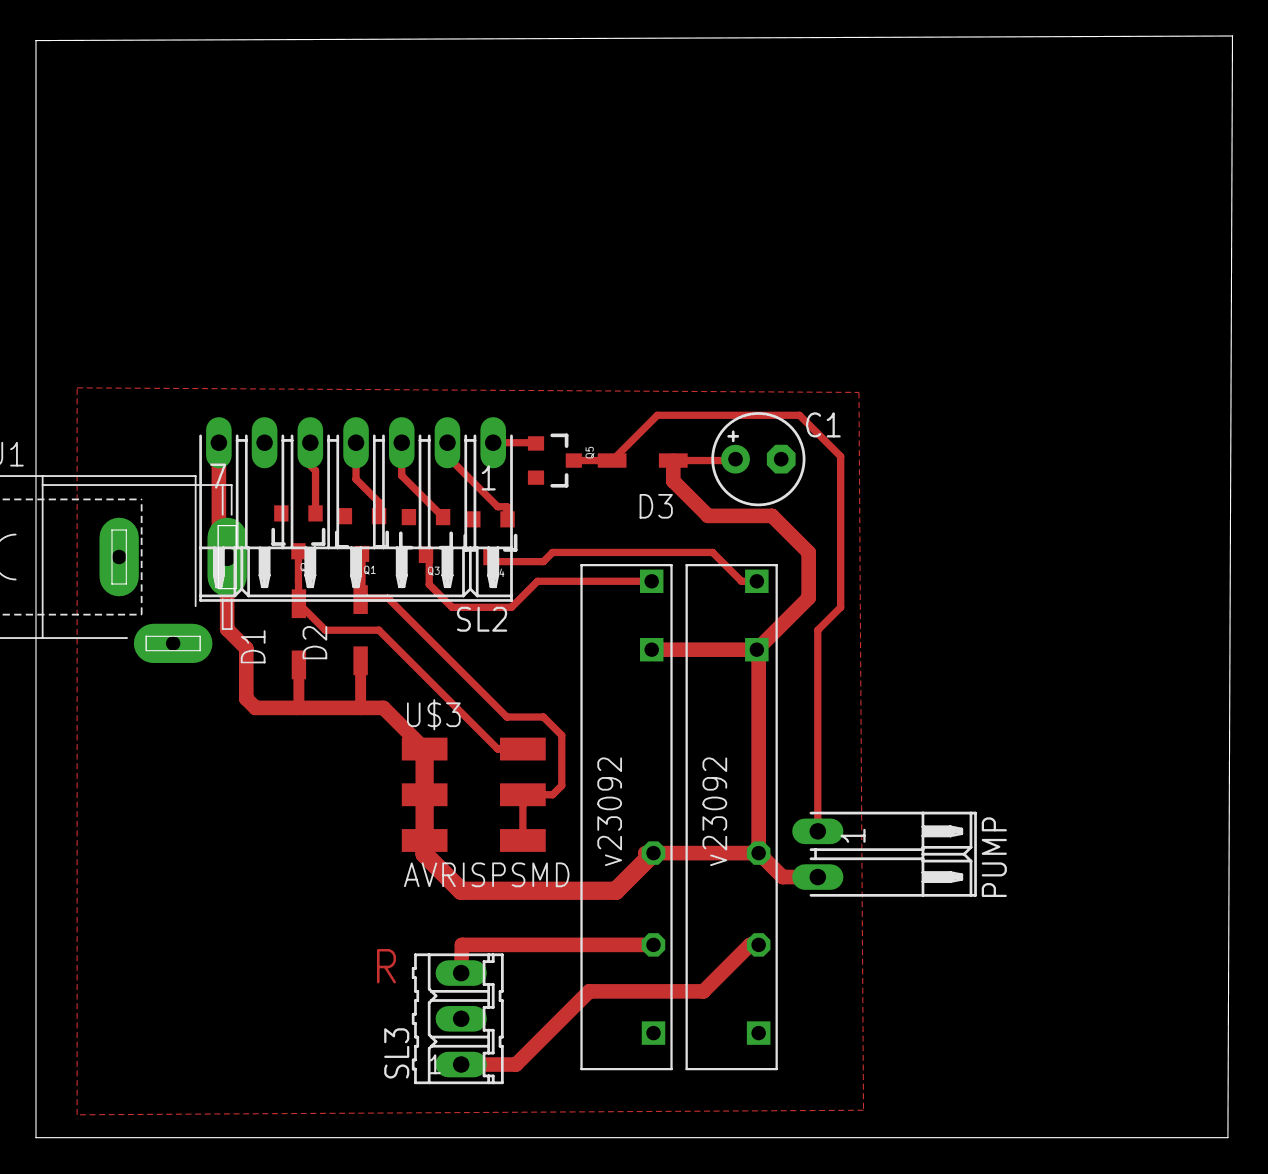
[picture p41: board in3temperature.brd from above]

Board: 2 copper layers, 66.5 x 61.2 mm, 16 parts (0 on the bottom side), 14 nets.
