aescariom/In3/circuits/In3Brain/in3brain.brd

## EAGLE design circuits/In3Brain/in3brain.brd (2017-02-27)

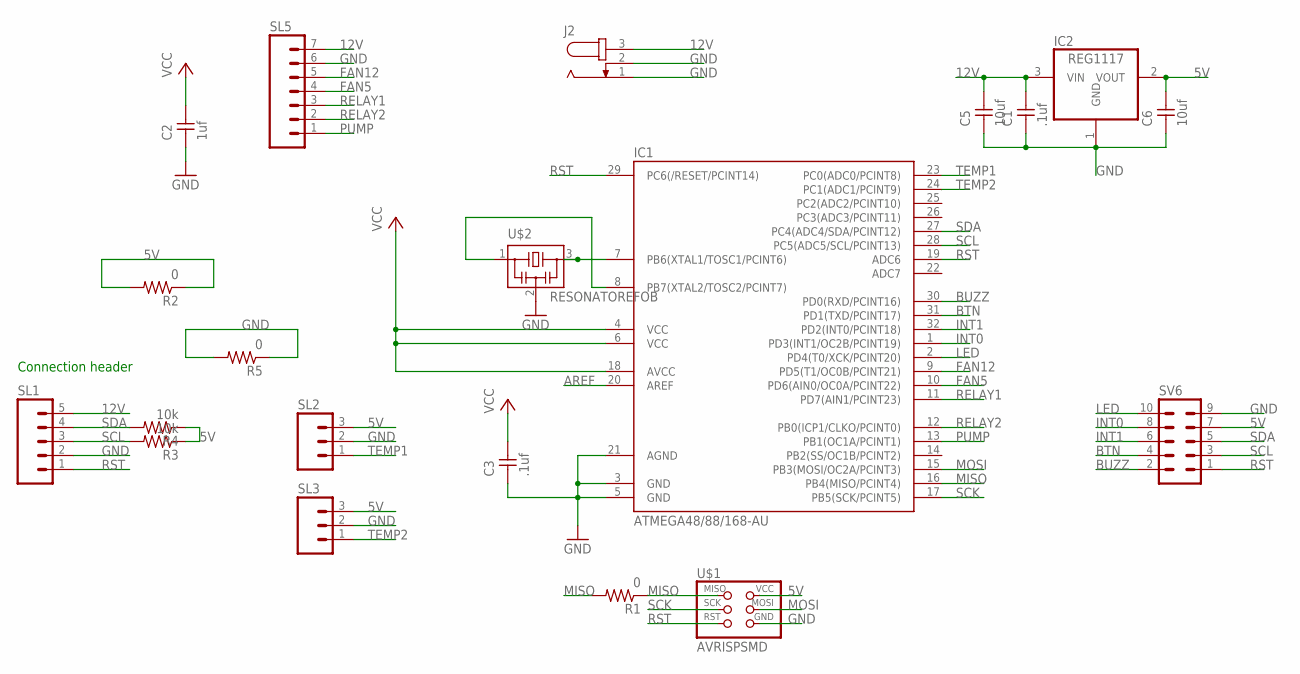
[picture p42: schematic in3brain.sch]

Parts:
C1, C3: .1uf; 1206
C2: 1uf; 1206
C5, C6: 10uf; 1206
IC1: ATMEGA48/88/168-AU; TQFP32-08
IC2: REG1117; SOT223
J2: JACK-PLUG1; SPC4078
R1, R2, R5: 0; 1206
R3, R4: 10k; 1206
SL1: MA05; 05PA
SL2, SL3: MA03; 03P
SL5: MA07; 07PA
SV6: MA05-2
U$1: AVRISPSMD; 2X03SMD
U$2: RESONATOREFOB; EFOBM

Connections:
5V: C2.2, C3.2, C6.2, IC1.4 (VCC), IC1.6 (VCC), IC1.18 (AVCC), IC2.2 (VOUT), R2.1, R2.2, R3.1, R4.1, SL2.3, SL3.3, SV6.7, U$1.2 (VCC)
12V: C1.2, C5.2, IC2.3 (VIN), J2.3, SL1.5, SL5.7
AREF: IC1.20 (AREF)
BTN: IC1.31 (PD1(TXD/PCINT17)), SV6.4
BUZZ: IC1.30 (PD0(RXD/PCINT16)), SV6.2
FAN5: IC1.10 (PD6(AIN0/OC0A/PCINT22)), SL5.4
FAN12: IC1.9 (PD5(T1/OC0B/PCINT21)), SL5.5
GND: C1.1, C2.1, C3.1, C5.1, C6.1, IC1.3 (GND), IC1.5 (GND), IC1.21 (AGND), IC2.1 (GND), J2.1, J2.2, R5.1, R5.2, SL1.2, SL2.2, SL3.2, SL5.6, SV6.9, U$1.6 (GND), U$2.2
INT0: IC1.1 (PD3(INT1/OC2B/PCINT19)), SV6.8
INT1: IC1.32 (PD2(INT0/PCINT18)), SV6.6
LED: IC1.2 (PD4(T0/XCK/PCINT20)), SV6.10
MISO: IC1.16 (PB4(MISO/PCINT4)), R1.1, R1.2, U$1.1 (MISO)
MOSI: IC1.15 (PB3(MOSI/OC2A/PCINT3)), U$1.4 (MOSI)
unnamed: IC1.8 (PB7(XTAL2/TOSC2/PCINT7)), U$2.1
unnamed: IC1.7 (PB6(XTAL1/TOSC1/PCINT6)), U$2.3
PUMP: IC1.13 (PB1(OC1A/PCINT1)), SL5.1
RELAY1: IC1.11 (PD7(AIN1/PCINT23)), SL5.3
RELAY2: IC1.12 (PB0(ICP1/CLKO/PCINT0)), SL5.2
RST: IC1.19 (ADC6), IC1.29 (PC6(/RESET/PCINT14)), SL1.1, SV6.1, U$1.5 (RST)
SCK: IC1.17 (PB5(SCK/PCINT5)), U$1.3 (SCK)
SCL: IC1.28 (PC5(ADC5/SCL/PCINT13)), R3.2, SL1.3, SV6.3
SDA: IC1.27 (PC4(ADC4/SDA/PCINT12)), R4.2, SL1.4, SV6.5
TEMP1: IC1.23 (PC0(ADC0/PCINT8)), SL2.1
TEMP2: IC1.24 (PC1(ADC1/PCINT9)), SL3.1

Notes on the sheet:
Connection header

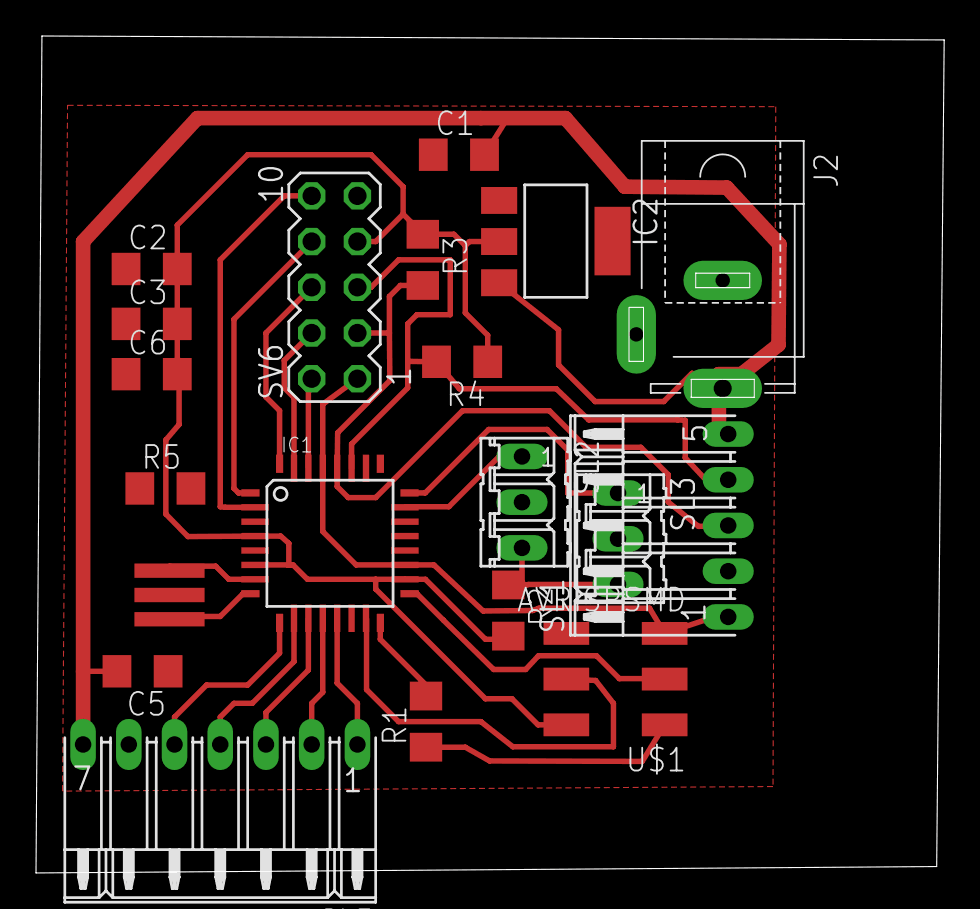
[picture p43: board in3brain.brd from above]

Board: 2 copper layers, 50.5 x 46.5 mm, 20 parts (0 on the bottom side), 23 nets.
