aescariom/In3/circuits/In3Bluetooth_HC-05/010 bluetooth.brd

## EAGLE design circuits/In3Bluetooth_HC-05/010 bluetooth.brd (2015-07-16)

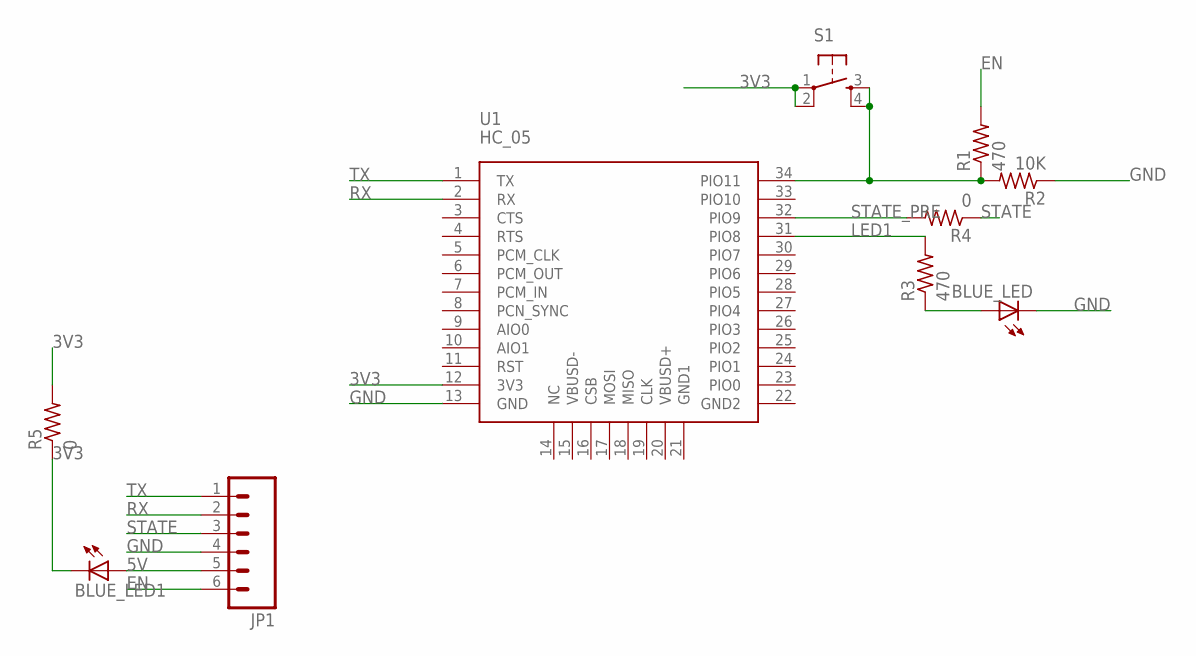
[picture p44: schematic 010 bluetooth.sch]

Parts:
BLUE_LED, BLUE_LED1: LED1206; 1206
JP1: M06LONGPADS; 1X06_LONGPADS
R1, R3: 470; 1206
R2: 10K; 1206
R4, R5: 0; 1206
S1: 6MM_SWITCH6MM_SWITCH; 6MM_SWITCH
U1: HC_05; BLUETOOTH_SMD

Connections:
3V3: BLUE_LED1.2 (C), R5.1, R5.2, S1.1, S1.2 (P1), U1.12 (3V3)
5V: BLUE_LED1.1 (A), JP1.5
EN: JP1.6, R1.2
GND: BLUE_LED.2 (C), JP1.4, R2.1, U1.13 (GND)
LED1: R3.2, U1.31 (PIO8)
unnamed: R1.1, R2.2, S1.3 (S), S1.4 (S1), U1.34 (PIO11)
unnamed: BLUE_LED.1 (A), R3.1
RX: JP1.2, U1.2 (RX)
STATE: JP1.3, R4.1
STATE_PRE: R4.2, U1.32 (PIO9)
TX: JP1.1, U1.1 (TX)

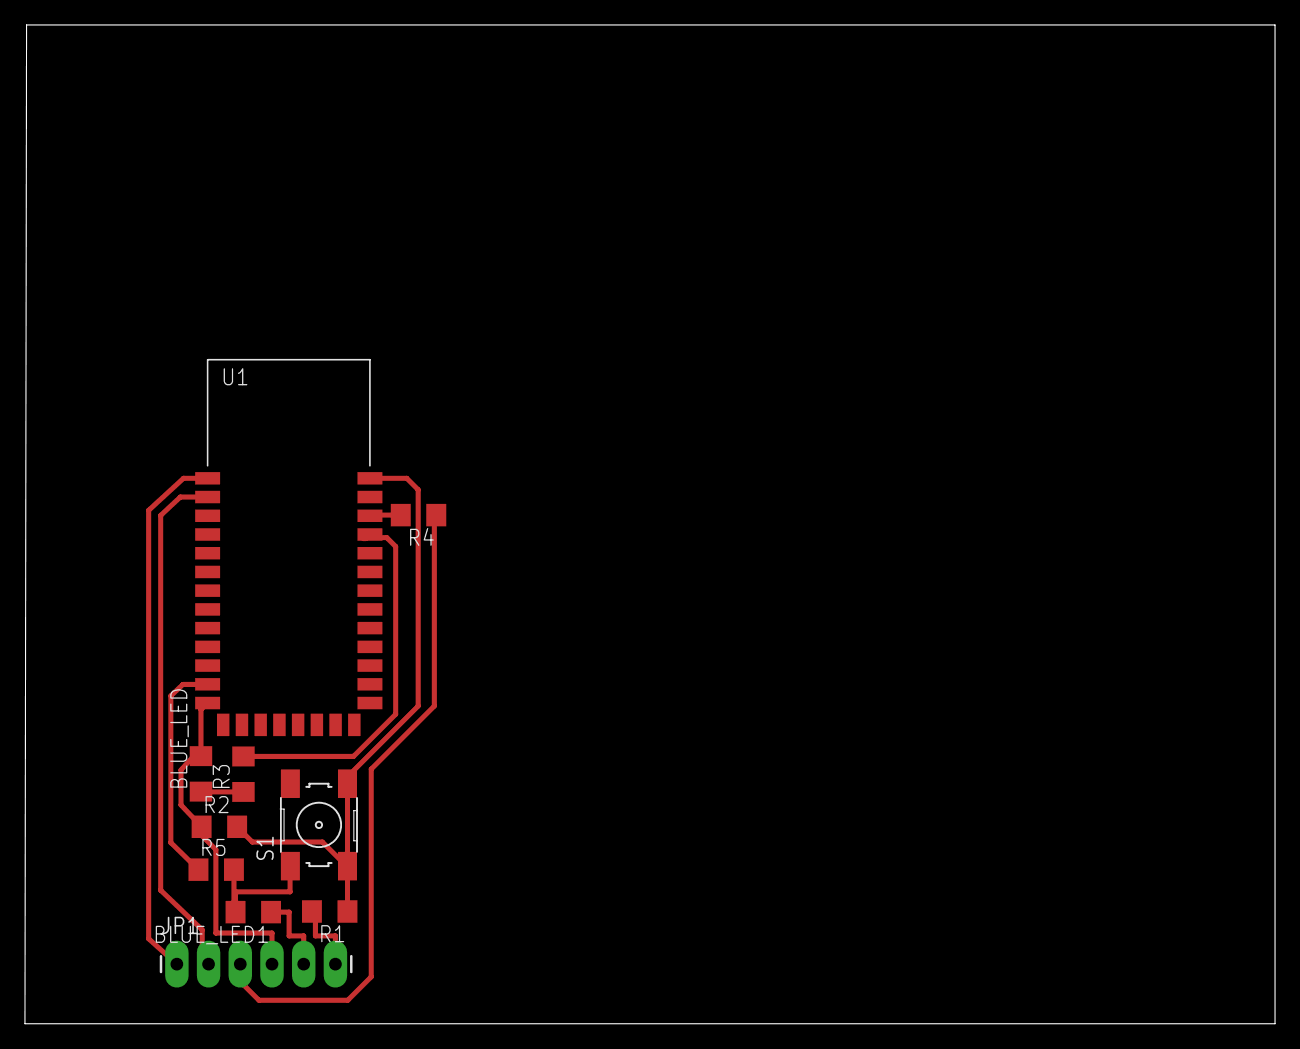
[picture p45: board 010 bluetooth.brd from above]

Board: 2 copper layers, 100.1 x 80.0 mm, 10 parts (0 on the bottom side), 11 nets.
