aescariom/In3/(commit log)

2015-07-16 In3 v1.0
    Version 1.0 of the incubator. The same that has been designed during
    FabAcademy 2015
    [010 bluetooth.brd, 010 bluetooth.sch, corner.stl, in3_base_35mm.dxf, in3_box_10mm.dxf, in3_controlpanel_3mm.dxf, in3_legs_17.5mm.dxf, in3brain.brd]
2015-09-20 Inner 12V fan speed changed
2015-09-20 Air flow
    Air flow 3D printed pieces.
    All of them can be printed without supports.
    [corner.stl, inner_ring.stl, left_nozzle.stl, nozzle_splitter.stl, outter_ring.stl, right_nozzle.stl, tube.stl]
2015-09-20 Axis mold files. Once the mold is made, a piece can be done in 5 minutes
    [negative_mold.stl]
2015-09-20 Structure update to v1.1.
    More stable and strong legs. Less cut time
    [in3_base_30mm.dxf, in3_base_35mm.dxf, in3_bed_15mm.dxf, in3_box_10mm.dxf, in3_controlpanel_3mm.dxf, in3_legs_17.5mm.dxf]
2015-09-20 Assembling documentation
2016-01-18 Electronics v2
    [in3brain.brd, in3brain.sch, in3controlpanel.brd, in3controlpanel.sch, in3peltier.brd, in3peltier.sch, in3temperature.brd, in3temperature.sch]
2017-02-27 New Electronics
    [in3brain.brd, in3brain.sch, in3controlpanel.brd, in3controlpanel.sch, in3peltier.brd, in3peltier.sch, in3temperature.brd, in3temperature.sch]
