aescariom/In3/(notices)

Notices in the files:
parts and their libraries:
01_SparkFun: Licensing: CC v3.0 Share-Alike You are welcome to use this library for commercial purposes.
